peterbaumert/obd-v2x-dongle/docs/img/pcb-bottom.png

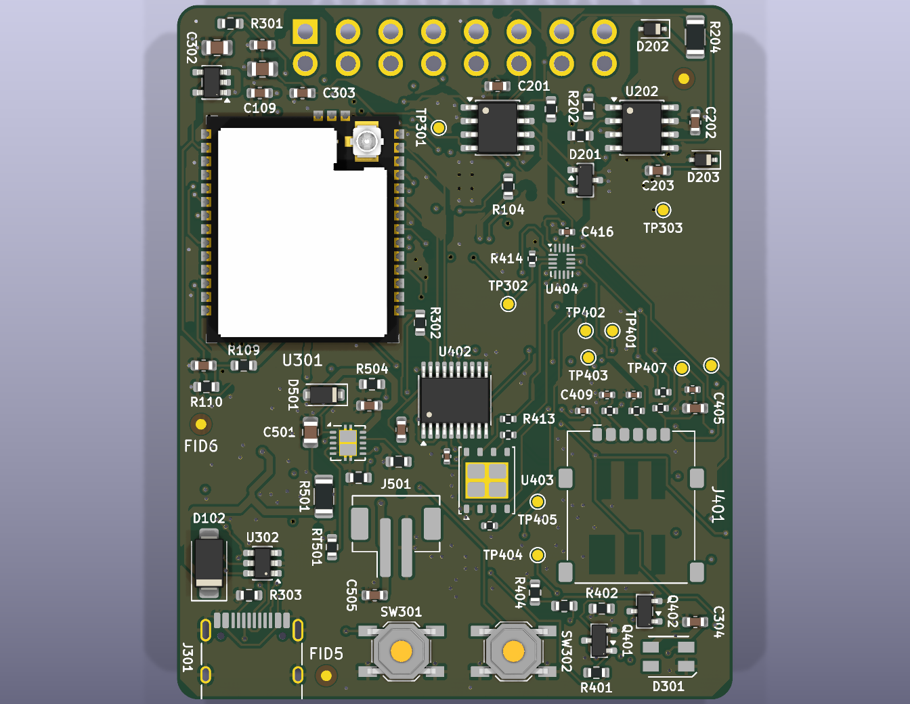
docs/img/pcb-bottom.png
