peterbaumert/obd-v2x-dongle/docs/img/pcb-top.png

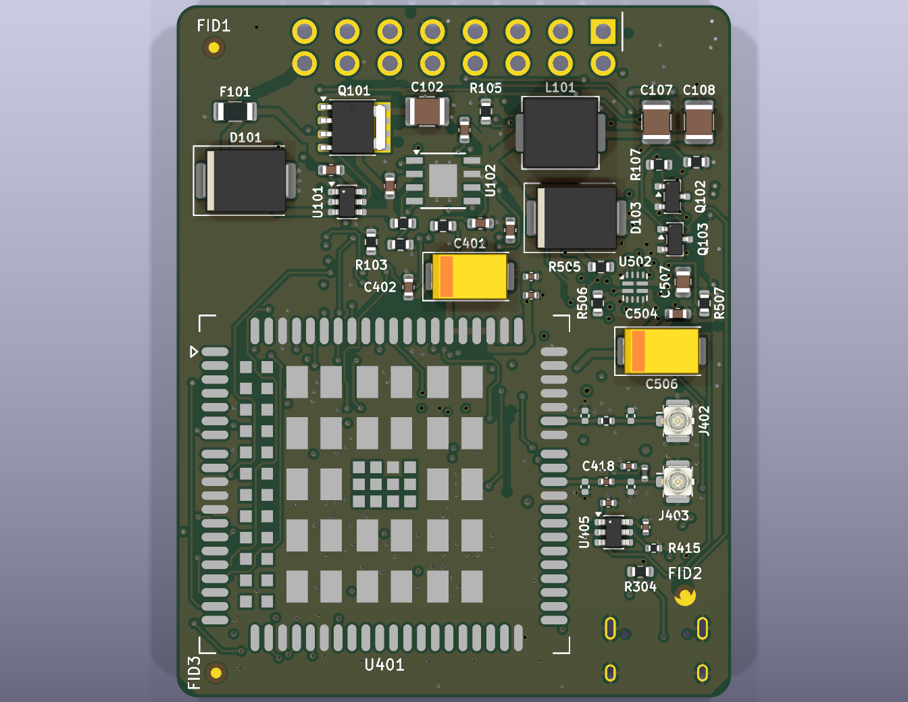
docs/img/pcb-top.png
