peterbaumert/obd-v2x-dongle/mechanical/out/case_bottom_shell.png

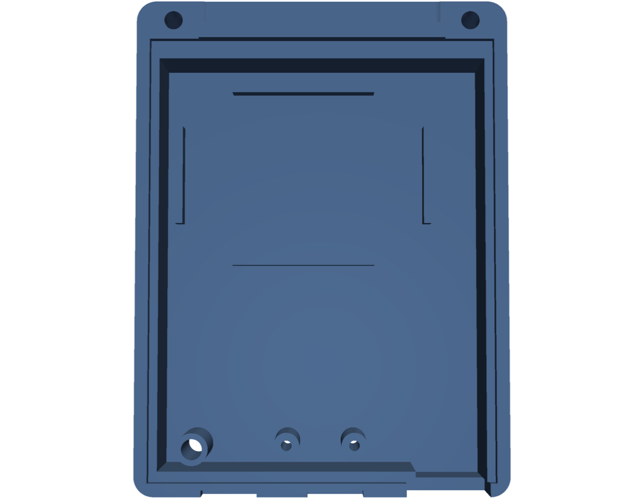
mechanical/out/case_bottom_shell.png
