peterbaumert/obd-v2x-dongle/mechanical/out/case_closed_rear.png

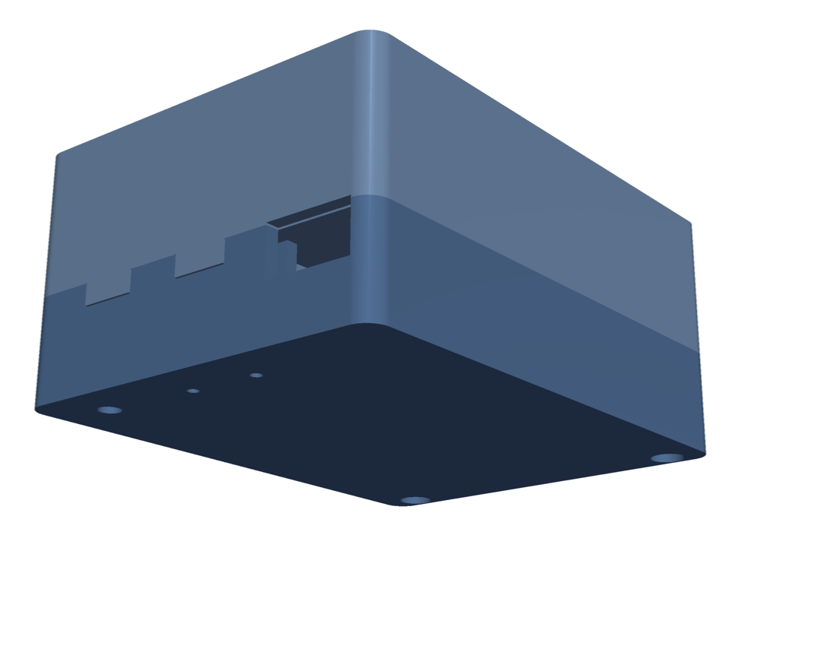
mechanical/out/case_closed_rear.png
