peterbaumert/obd-v2x-dongle/mechanical/out/case_lid_inside.png

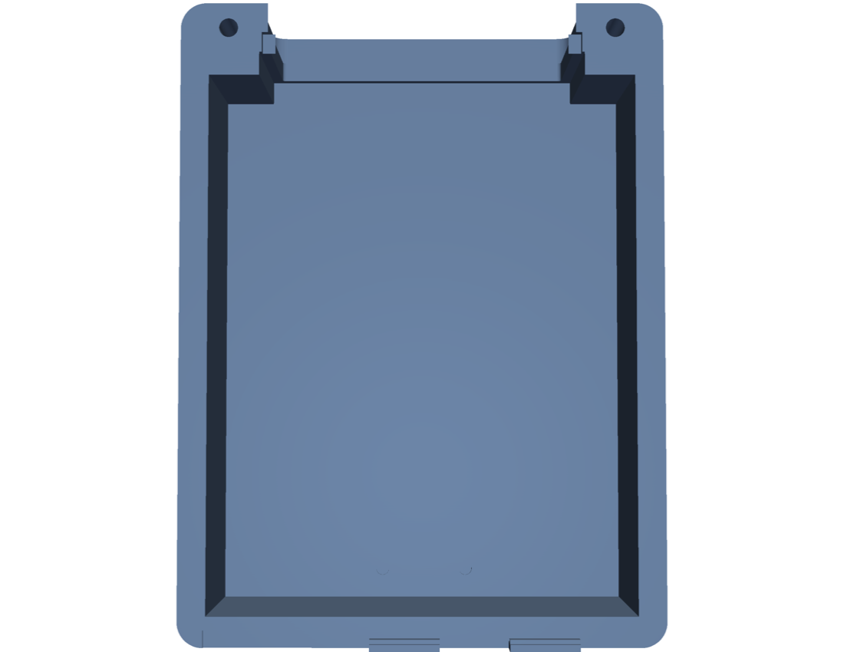
mechanical/out/case_lid_inside.png
