peterbaumert/obd-v2x-dongle/docs/bom.csv

Reference | Value | Footprint | MPN | Manufacturer | LCSC | Qty | DNP
C101,C104,C111,C201,C303,C304,C402,C405,C406 | 100nF | Capacitor_SMD:C_0603_1608Metric |  |  |  | 9
C102 | 10uF 50V | Capacitor_SMD:C_1210_3225Metric |  |  |  | 1
C103,C202 | 100nF 50V | Capacitor_SMD:C_0603_1608Metric |  |  |  | 2
C105 | 5.6nF | Capacitor_SMD:C_0603_1608Metric |  |  |  | 1
C106 | 47pF | Capacitor_SMD:C_0603_1608Metric |  |  |  | 1
C107,C108 | 47uF 10V | Capacitor_SMD:C_1210_3225Metric |  |  |  | 2
C109,C301,C502,C505 | 1uF | Capacitor_SMD:C_0603_1608Metric |  |  |  | 4
C110,C302,C507 | 10uF | Capacitor_SMD:C_0805_2012Metric |  |  |  | 3
C203 | 220pF 50V | Capacitor_SMD:C_0603_1608Metric |  |  |  | 1
C401 | 220uF 6.3V | Capacitor_Tantalum_SMD:CP_EIA-7343-31_Kemet-D | T495D227K006ATE100 | Kemet | C2798131 | 1
C403,C407,C408,C409 | 33pF | Capacitor_SMD:C_0402_1005Metric |  |  |  | 4
C404 | 10pF | Capacitor_SMD:C_0402_1005Metric |  |  |  | 1
C410,C415,C416,C419,C420 | 100nF | Capacitor_SMD:C_0402_1005Metric |  |  |  | 5
C411,C412,C413,C414 | DNP | Capacitor_SMD:C_0402_1005Metric |  |  |  | 4 | DNP
C417,C418 | 33pF | Capacitor_SMD:C_0402_1005Metric | 0402CG330J500NT | FH | C1562 | 2
C501 | 1uF 50V | Capacitor_SMD:C_0805_2012Metric |  |  |  | 1
C504 | 10nF | Capacitor_SMD:C_0603_1608Metric |  |  |  | 1
C506 | 220uF | Capacitor_Tantalum_SMD:CP_EIA-7343-31_Kemet-D | T495D227K006ATE100 | KEMET | C2798131 | 1
D101 | SMCJ33CA | Diode_SMD:D_SMC | SMCJ33CA | Littelfuse | C310048 | 1
D102 | SS14 | Diode_SMD:D_SMA | SS14 | MDD | C2480 | 1
D103 | B560C | Diode_SMD:D_SMC | B560C-13-F | Diodes Inc | C85100 | 1
D201 | NUP2105L | Package_TO_SOT_SMD:SOT-23 | SZNUP2105LT1G | onsemi | C233494 | 1
D202 | B0540WS | Diode_SMD:D_SOD-323 | B0540WS-7 | Diodes Inc | C52754523 | 1
D203 | PESD1LIN | Diode_SMD:D_SOD-323 | PESD1LIN,115 | Nexperia | C58901 | 1
D301 | SK6812MINI-HS | obd-v2x:LED_SK6812MINI-HS_3.7x3.5mm | SK6812MINI-HS | OPSCO | C2922787 | 1
D501 | SMF24A | Diode_SMD:D_SOD-123F | SMF24A | Littelfuse | C315999 | 1
F101 | 2A slow | Fuse:Fuse_1206_3216Metric | 0466002.NRHF | Littelfuse | C3105 | 1
J201 | OBD2_J1962_Plug | obd-v2x:OBD2_J1962_Plug_PCB | CR-PG001 (OBD2 male 90deg PCB, hand-fitted) | Jiatel or equivalent |  | 1
J301 | USB-C | Connector_USB:USB_C_Receptacle_HRO_TYPE-C-31-M-12 | TYPE-C-31-M-12 | HRO | C165948 | 1
J401 | Nano-SIM | Connector_Card:nanoSIM_GCT_SIM8060-6-0-14-00 | SIM8060-6-0-14-00-A | GCT | C6296715 | 1
J402 | U.FL LTE main | Connector_Coaxial:U.FL_Hirose_U.FL-R-SMT-1_Vertical | U.FL-R-SMT-1(10) | Hirose | C88373 | 1
J403 | U.FL GNSS | Connector_Coaxial:U.FL_Hirose_U.FL-R-SMT-1_Vertical | U.FL-R-SMT-1(10) | Hirose | C88373 | 1
J501 | Battery 1S | Connector_JST:JST_PH_B2B-PH-SM4-TB_1x02-1MP_P2.00mm_Vertical | B2B-PH-SM4-TB(LF)(SN) | JST | C160352 | 1
L101 | 6.8uH 4.5A | Inductor_SMD:L_Sunlord_MWSA0605S | MWSA0605S-6R8MT | Sunlord | C408466 | 1
L401 | 27nH | Inductor_SMD:L_0402_1005Metric | LQG15HS27NJ02D | Murata | C12669 | 1
Q101 | PSMN7R0-60YS | Package_TO_SOT_SMD:LFPAK56 | PSMN7R0-60YS,115 | Nexperia | C478143 | 1
Q102 | AO3401A | Package_TO_SOT_SMD:SOT-23 | AO3401A | AOS | C15127 | 1
Q103 | 2N7002 | Package_TO_SOT_SMD:SOT-23 | 2N7002 | onsemi | C8545 | 1
Q401,Q402 | MMBT3904 | Package_TO_SOT_SMD:SOT-23 | MMBT3904 | onsemi | C20526 | 2
R101 | 470k | Resistor_SMD:R_0603_1608Metric |  |  |  | 1
R102 | 120k | Resistor_SMD:R_0603_1608Metric |  |  |  | 1
R103 | 162k | Resistor_SMD:R_0603_1608Metric |  |  |  | 1
R104 | 37.4k | Resistor_SMD:R_0603_1608Metric |  |  |  | 1
R105,R110,R201,R301,R302 | 10k | Resistor_SMD:R_0603_1608Metric |  |  |  | 5
R106 | 12k | Resistor_SMD:R_0603_1608Metric |  |  |  | 1
R107,R108,R109,R203 | 100k | Resistor_SMD:R_0603_1608Metric |  |  |  | 4
R202,R401,R403 | 4.7k | Resistor_SMD:R_0603_1608Metric |  |  |  | 3
R204 | 510 0.5W | Resistor_SMD:R_1206_3216Metric |  |  |  | 1
R303,R304 | 5.1k | Resistor_SMD:R_0603_1608Metric |  |  |  | 2
R402,R404 | 47k | Resistor_SMD:R_0603_1608Metric |  |  |  | 2
R405,R406,R407,R411,R412,R413 | 22R | Resistor_SMD:R_0402_1005Metric |  |  |  | 6
R408 | 15k | Resistor_SMD:R_0402_1005Metric |  |  |  | 1
R409 | 0R | Resistor_SMD:R_0402_1005Metric |  |  |  | 1
R414 | 100k | Resistor_SMD:R_0402_1005Metric |  |  |  | 1
R415 | 232k | Resistor_SMD:R_0402_1005Metric |  |  |  | 1
R501 | 33R 0.5W | Resistor_SMD:R_1206_3216Metric |  |  |  | 1
R502 | 4.3k | Resistor_SMD:R_0603_1608Metric |  |  |  | 1
R503 | 24k 1% | Resistor_SMD:R_0603_1608Metric |  |  |  | 1
R504,R505 | 82k 1% | Resistor_SMD:R_0603_1608Metric |  |  |  | 2
R506 | 10k 1% | Resistor_SMD:R_0603_1608Metric |  |  |  | 1
R507 | 30.1k 1% | Resistor_SMD:R_0603_1608Metric |  |  |  | 1
RT501 | 10k NTC | Resistor_SMD:R_0603_1608Metric | SDNT1608X103F3435FTF | Sunlord | C525660 | 1
SW301 | RESET | Button_Switch_SMD:SW_SPST_TL3342 | TL3342F450QG | E-Switch | C2886897 | 1
SW302 | BOOT | Button_Switch_SMD:SW_SPST_TL3342 | TL3342F450QG | E-Switch | C2886897 | 1
TP301 | UART0_TX | TestPoint:TestPoint_Pad_D1.0mm |  |  |  | 1
TP302 | SIM_SEL | TestPoint:TestPoint_Pad_D1.0mm |  |  |  | 1
TP303 | GND | TestPoint:TestPoint_Pad_D1.0mm |  |  |  | 1
TP401 | LTE_USB_VBUS | TestPoint:TestPoint_Pad_D1.0mm |  |  |  | 1
TP402 | LTE_USB_DP | TestPoint:TestPoint_Pad_D1.0mm |  |  |  | 1
TP403 | LTE_USB_DM | TestPoint:TestPoint_Pad_D1.0mm |  |  |  | 1
TP404 | LTE_USB_BOOT | TestPoint:TestPoint_Pad_D1.0mm |  |  |  | 1
TP405 | LTE_DBG_TXD | TestPoint:TestPoint_Pad_D1.0mm |  |  |  | 1
TP406 | LTE_DBG_RXD | TestPoint:TestPoint_Pad_D1.0mm |  |  |  | 1
TP407 | LTE_1V8 | TestPoint:TestPoint_Pad_D1.0mm |  |  |  | 1
U101 | LM74700-Q1 | Package_TO_SOT_SMD:SOT-23-6 | LM74700QDBVRQ1 | TI | C2941042 | 1
U102 | TPS54360DDA | Package_SO:TI_SO-PowerPAD-8_ThermalVias | TPS54360DDAR | TI | C44377 | 1
U103 | TLV75733PDBV | Package_TO_SOT_SMD:SOT-23-5 | TLV75733PDBVR | TI | C485517 | 1
U201 | TCAN334 | Package_SO:SOIC-8_3.9x4.9mm_P1.27mm | TCAN334DR | TI | C2871143 | 1
U202 | TJA1021T/20 | Package_SO:SOIC-8_3.9x4.9mm_P1.27mm | TJA1021T/20/CM,118 | NXP | C128810 | 1
U301 | ESP32-C5-WROOM-1U-N16R8 | obd-v2x:ESP32-C5-WROOM-1U | ESP32-C5-WROOM-1U-N16R8-V1.2 | Espressif | C54951857 | 1
U302 | USBLC6-2SC6 | Package_TO_SOT_SMD:SOT-23-6 | USBLC6-2SC6 | ST | C2827654 | 1
U401 | EC200U-EU | obd-v2x:Quectel_EC200U | EC200UEUAA-N05-SGNSA | Quectel | C2942341 | 1
U402 | TXS0108EPW | Package_SO:TSSOP-20_4.4x6.5mm_P0.65mm | TXS0108EPWR | TI | C17206 | 1
U403 | eSIM MFF2 | Package_SON:WSON-8-1EP_6x5mm_P1.27mm_EP3.4x4mm | MFF2 eSIM, optional (DNP) |  |  | 1 | DNP
U404 | FSA2567UMX | Package_DFN_QFN:UQFN-16_1.8x2.6mm_P0.4mm | FSA2567UMX | onsemi | C357761 | 1
U405 | TPS2552DBVR-1 | Package_TO_SOT_SMD:SOT-23-6 | TPS2552DBVR-1 | TI | C140331 | 1
U501 | BQ25171-Q1 | Package_SON:Texas_DRC0010J | BQ25171QWDRCRQ1 | Texas Instruments | C2861221 | 1
U502 | TPS2121 | Package_DFN_QFN:Texas_VQFN-HR-12_2x2.5mm_P0.5mm | TPS2121RUXR | Texas Instruments | C485916 | 1
