peterbaumert/obd-v2x-dongle/mechanical/out/case_bottom.step

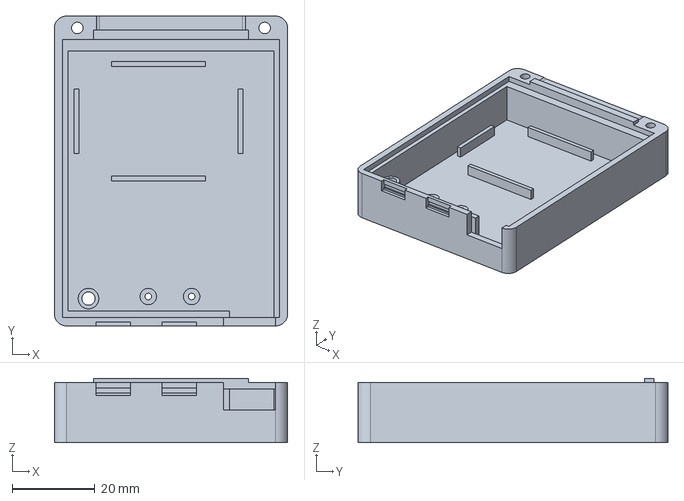
[picture p9: CAD file, 2026-11-13]
mechanical/out/case_bottom.step
56.6 x 75.2 x 15.6 mm
