peterbaumert/obd-v2x-dongle/mechanical/out/case_lid.step

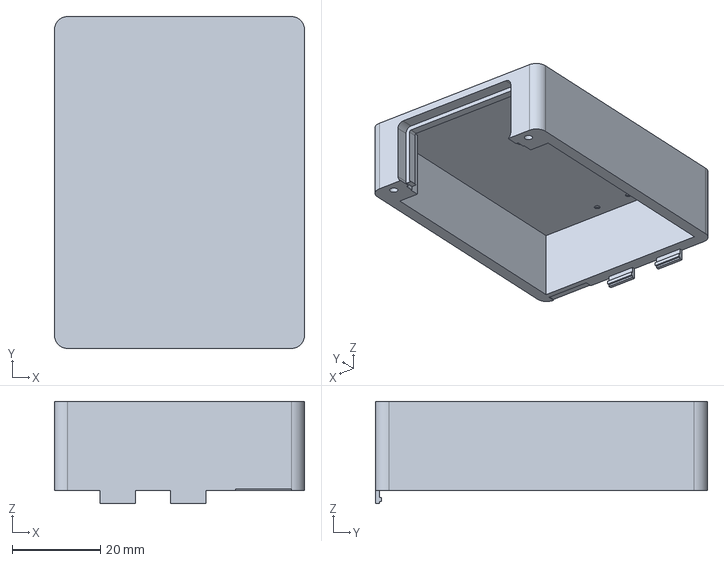
[picture p10: CAD file, 2026-11-13]
mechanical/out/case_lid.step
56.6 x 75.2 x 23.1 mm
