peterbaumert/obd-v2x-dongle/(list of files, cad)

Other CAD files:
mechanical/out/case_bottom.stl
mechanical/out/case_lid.stl
