peterbaumert/obd-v2x-dongle/docs/schematic.pdf

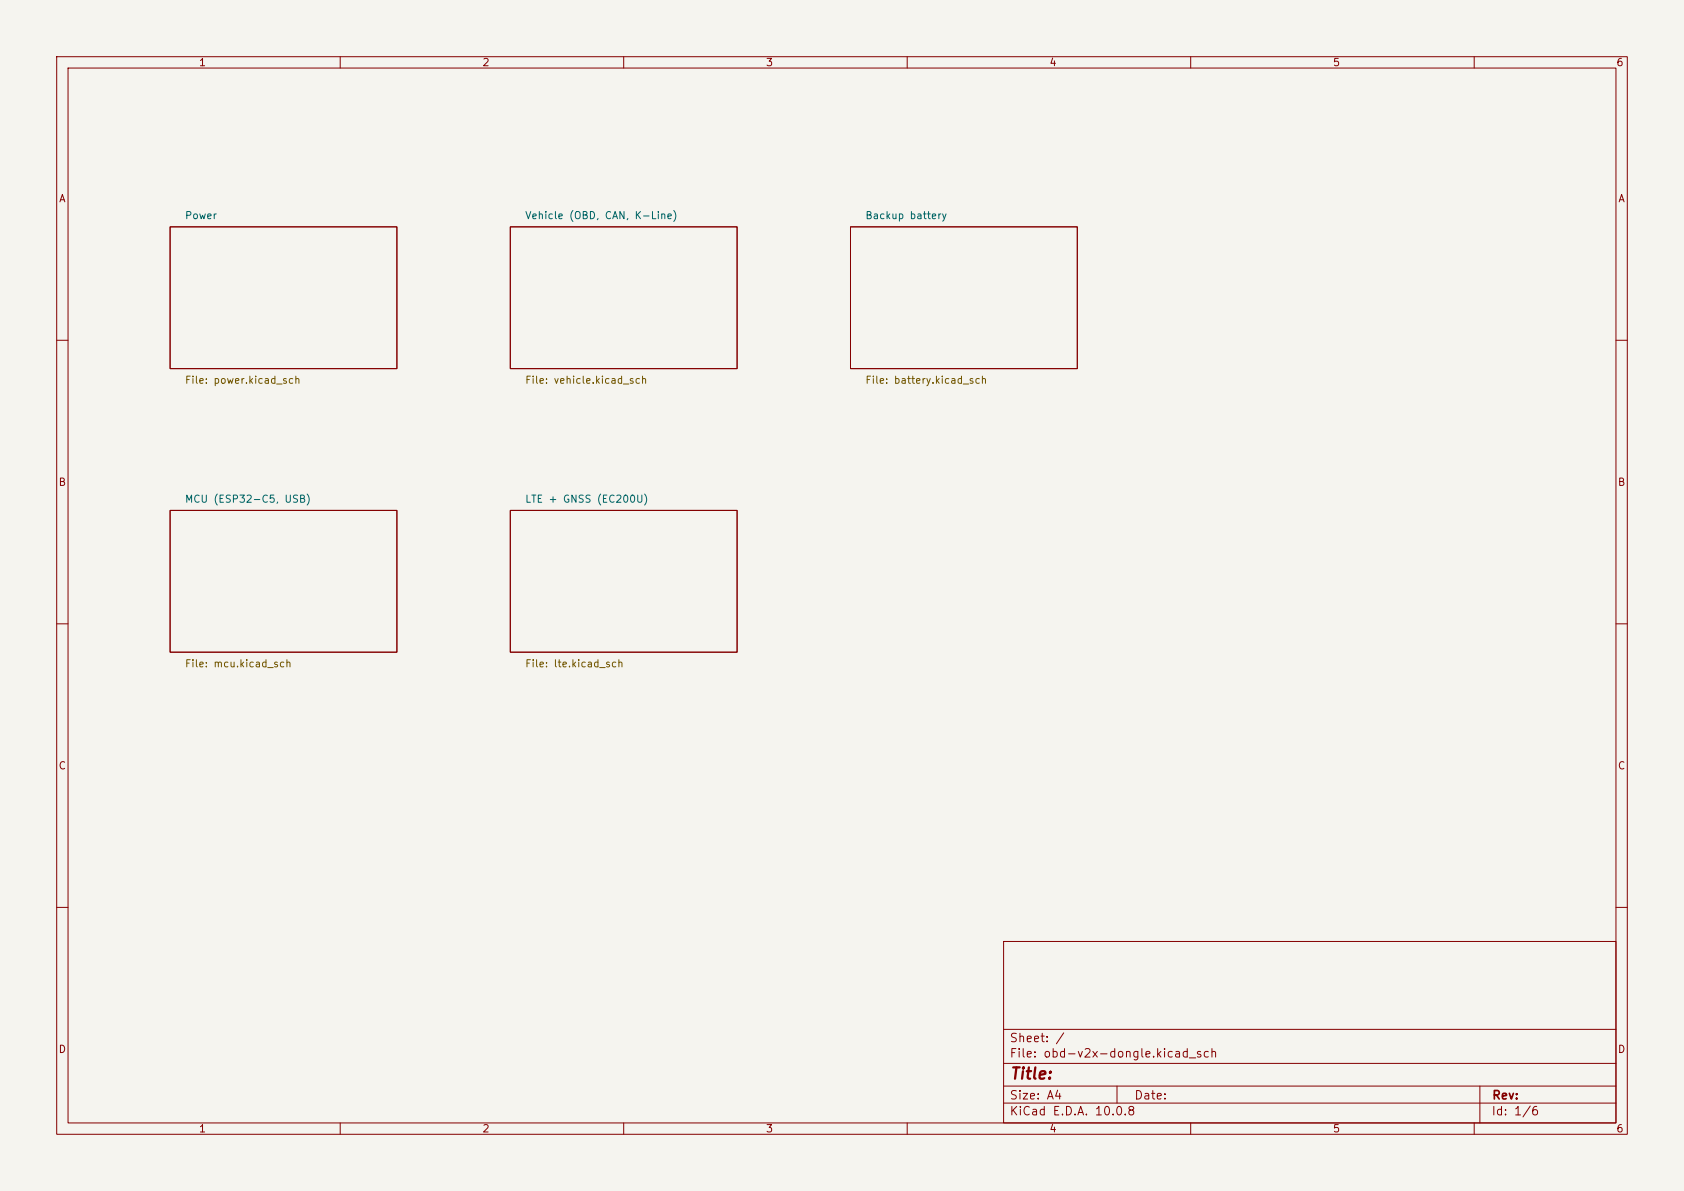
[picture p11: page 1]

LTE + GNSS (EC200U) File: lte.kicad_sch MCU (ESP32-C5, USB) File: mcu.kicad_sch Power File: power.kicad_sch

Size: A4 | Rev:
KiCad E.D.A. 10.0.8 | Id: 1/6

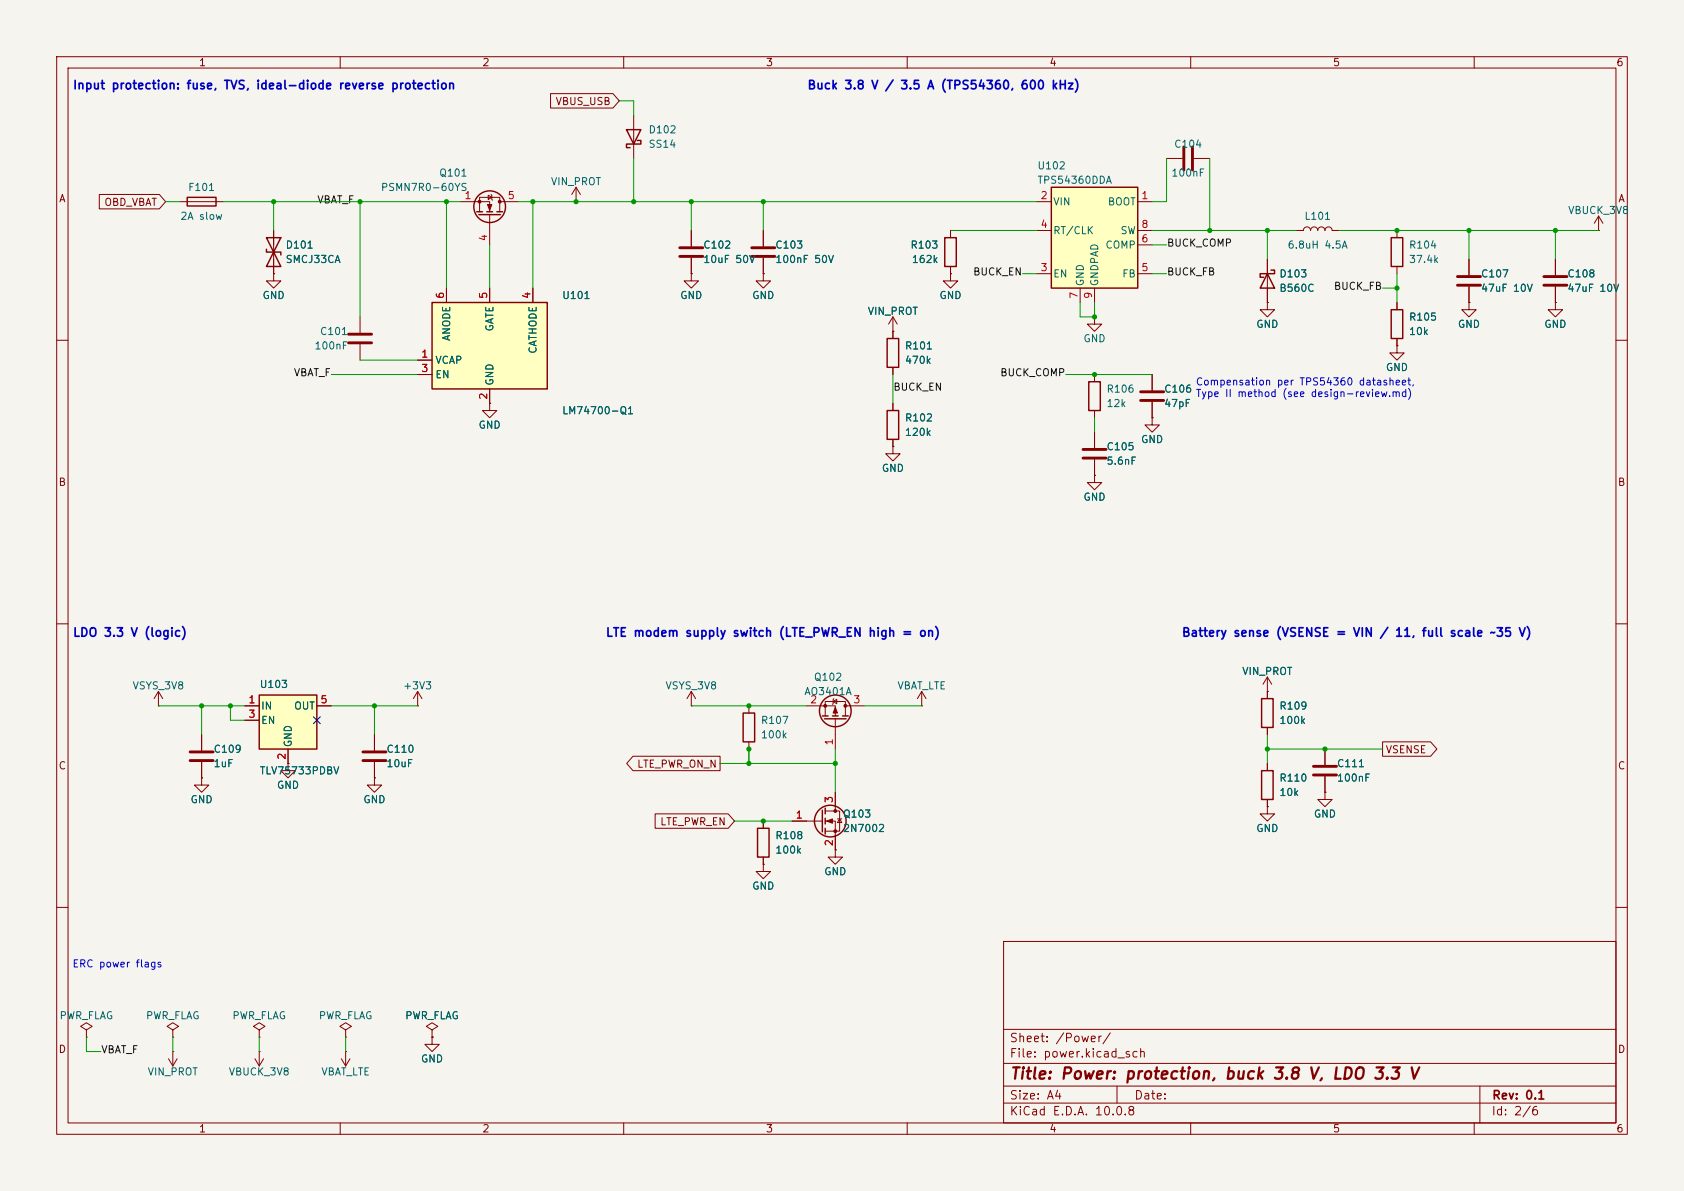
[picture p12: page 2]

Battery sense (VSENSE = VIN / 11, full scale ~35 V) R101

Compensation per TPS54360 datasheet,
Type II method (see design-review.md)

LTE modem supply switch (LTE_PWR_EN high = on)

Sheet: /Power/
File: power.kicad_sch
Title: Power: protection, buck 3.8 V, LDO 3.3 V

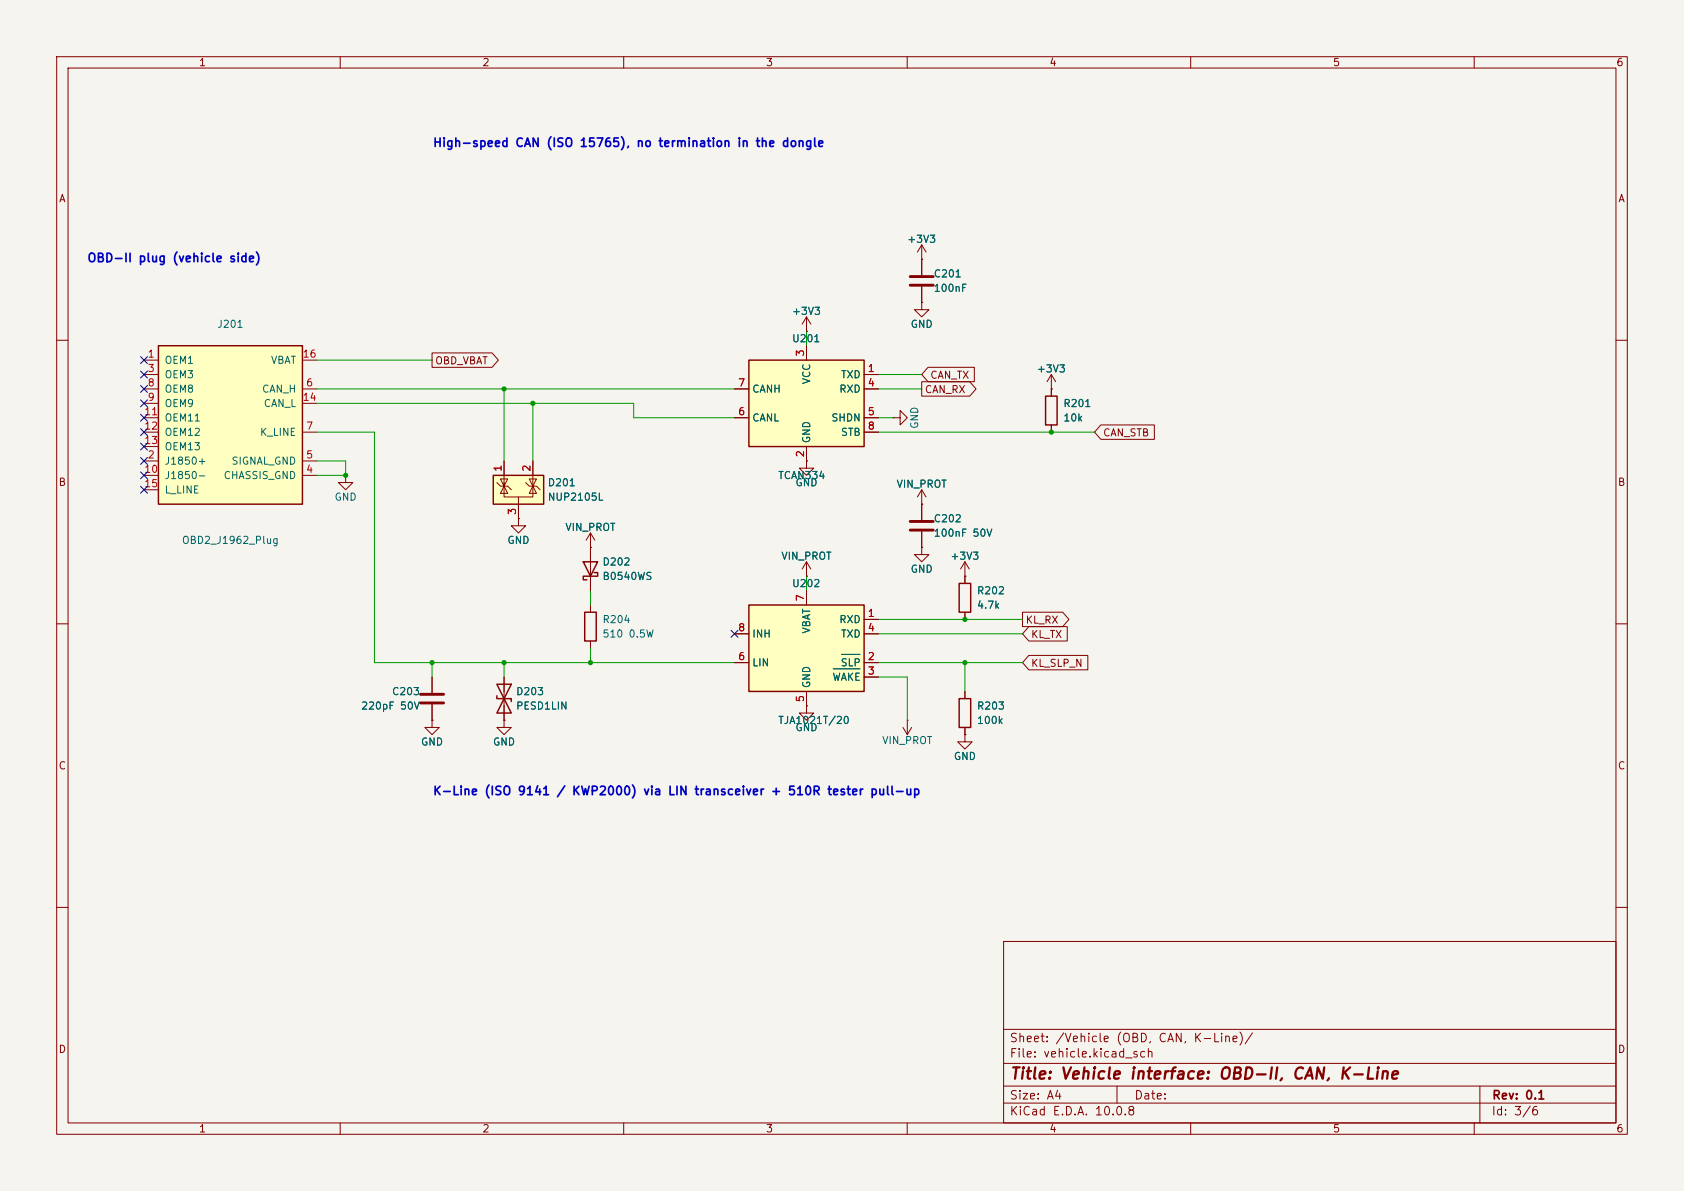
[picture p13: page 3]

High-speed CAN (ISO 15765), no termination in the dongle

K-Line (ISO 9141 / KWP2000) via LIN transceiver + 510R tester pull-up

Sheet: /Vehicle (OBD, CAN, K-Line)/
File: vehicle.kicad_sch
Title: Vehicle interface: OBD-II, CAN, K-Line

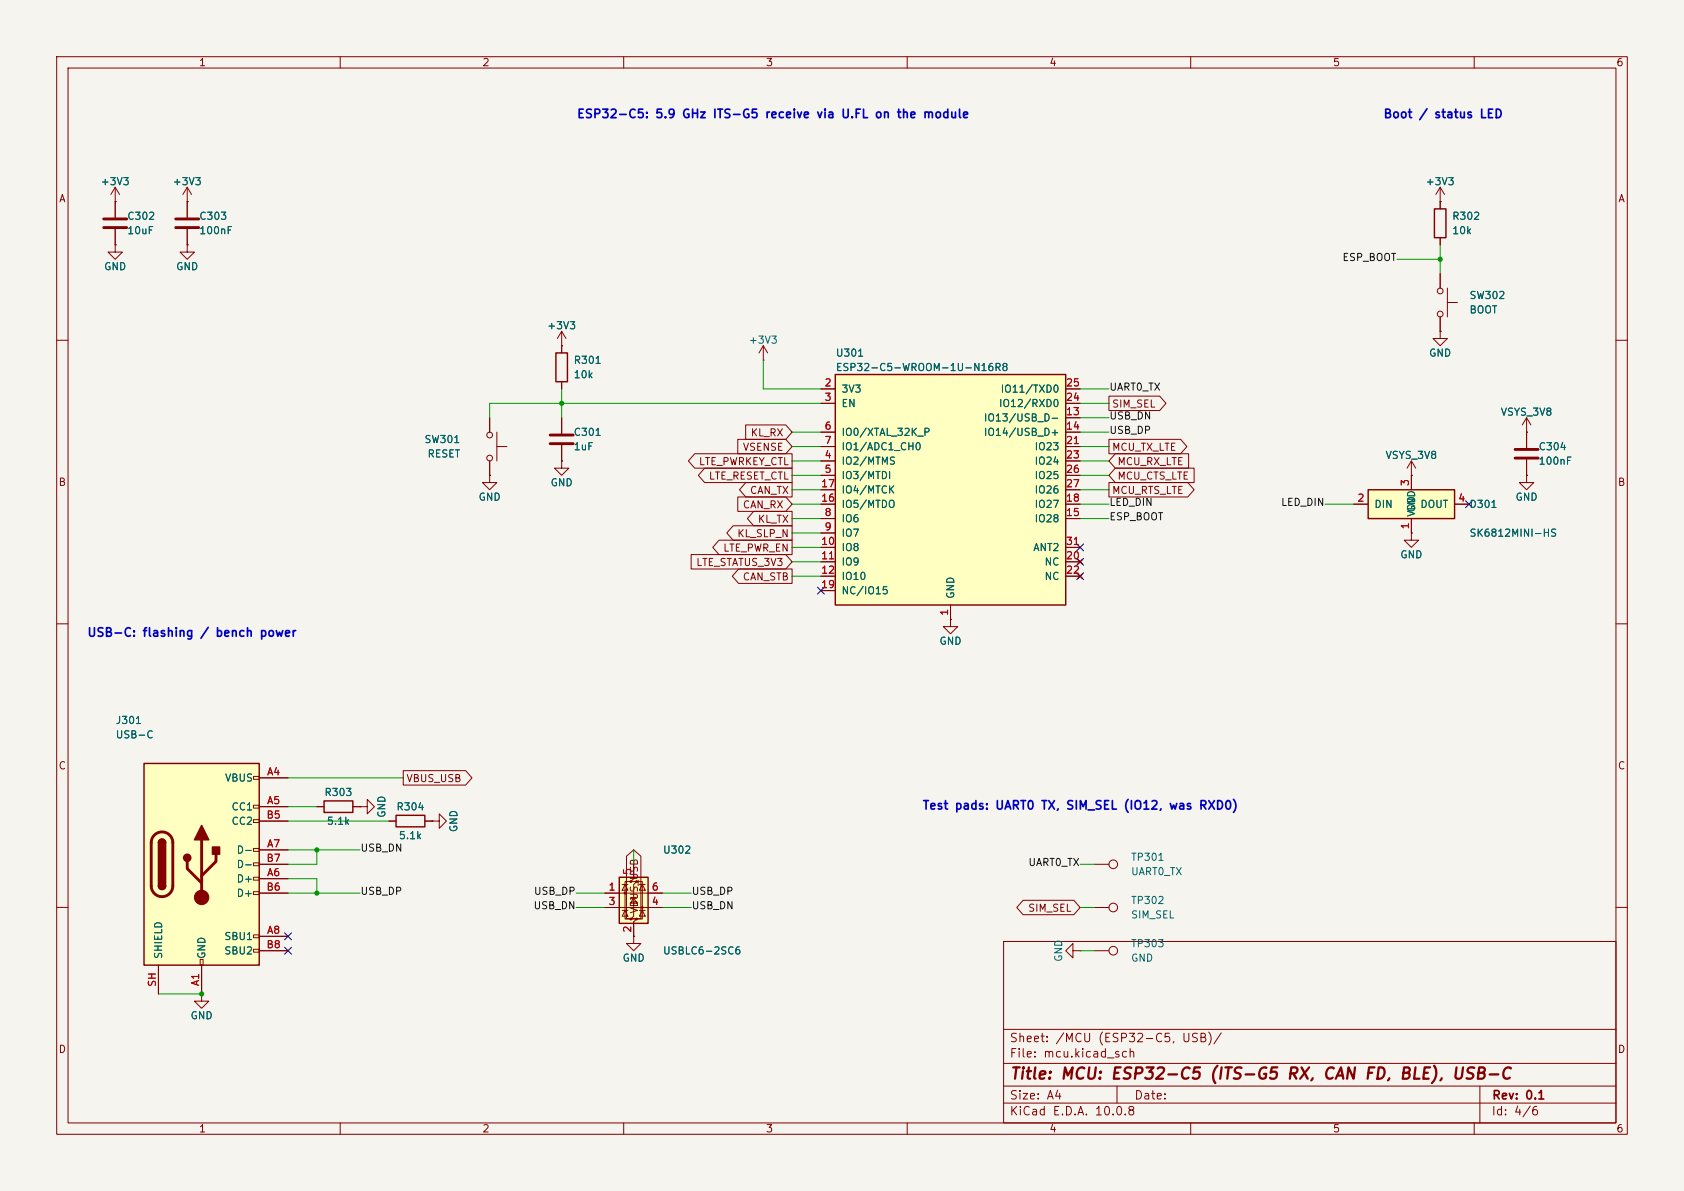
[picture p14: page 4]

Test pads: UART0 TX, SIM_SEL (IO12, was RXD0)

Sheet: /MCU (ESP32-C5, USB)/
File: mcu.kicad_sch
Title: MCU: ESP32-C5 (ITS-G5 RX, CAN FD, BLE), USB-C

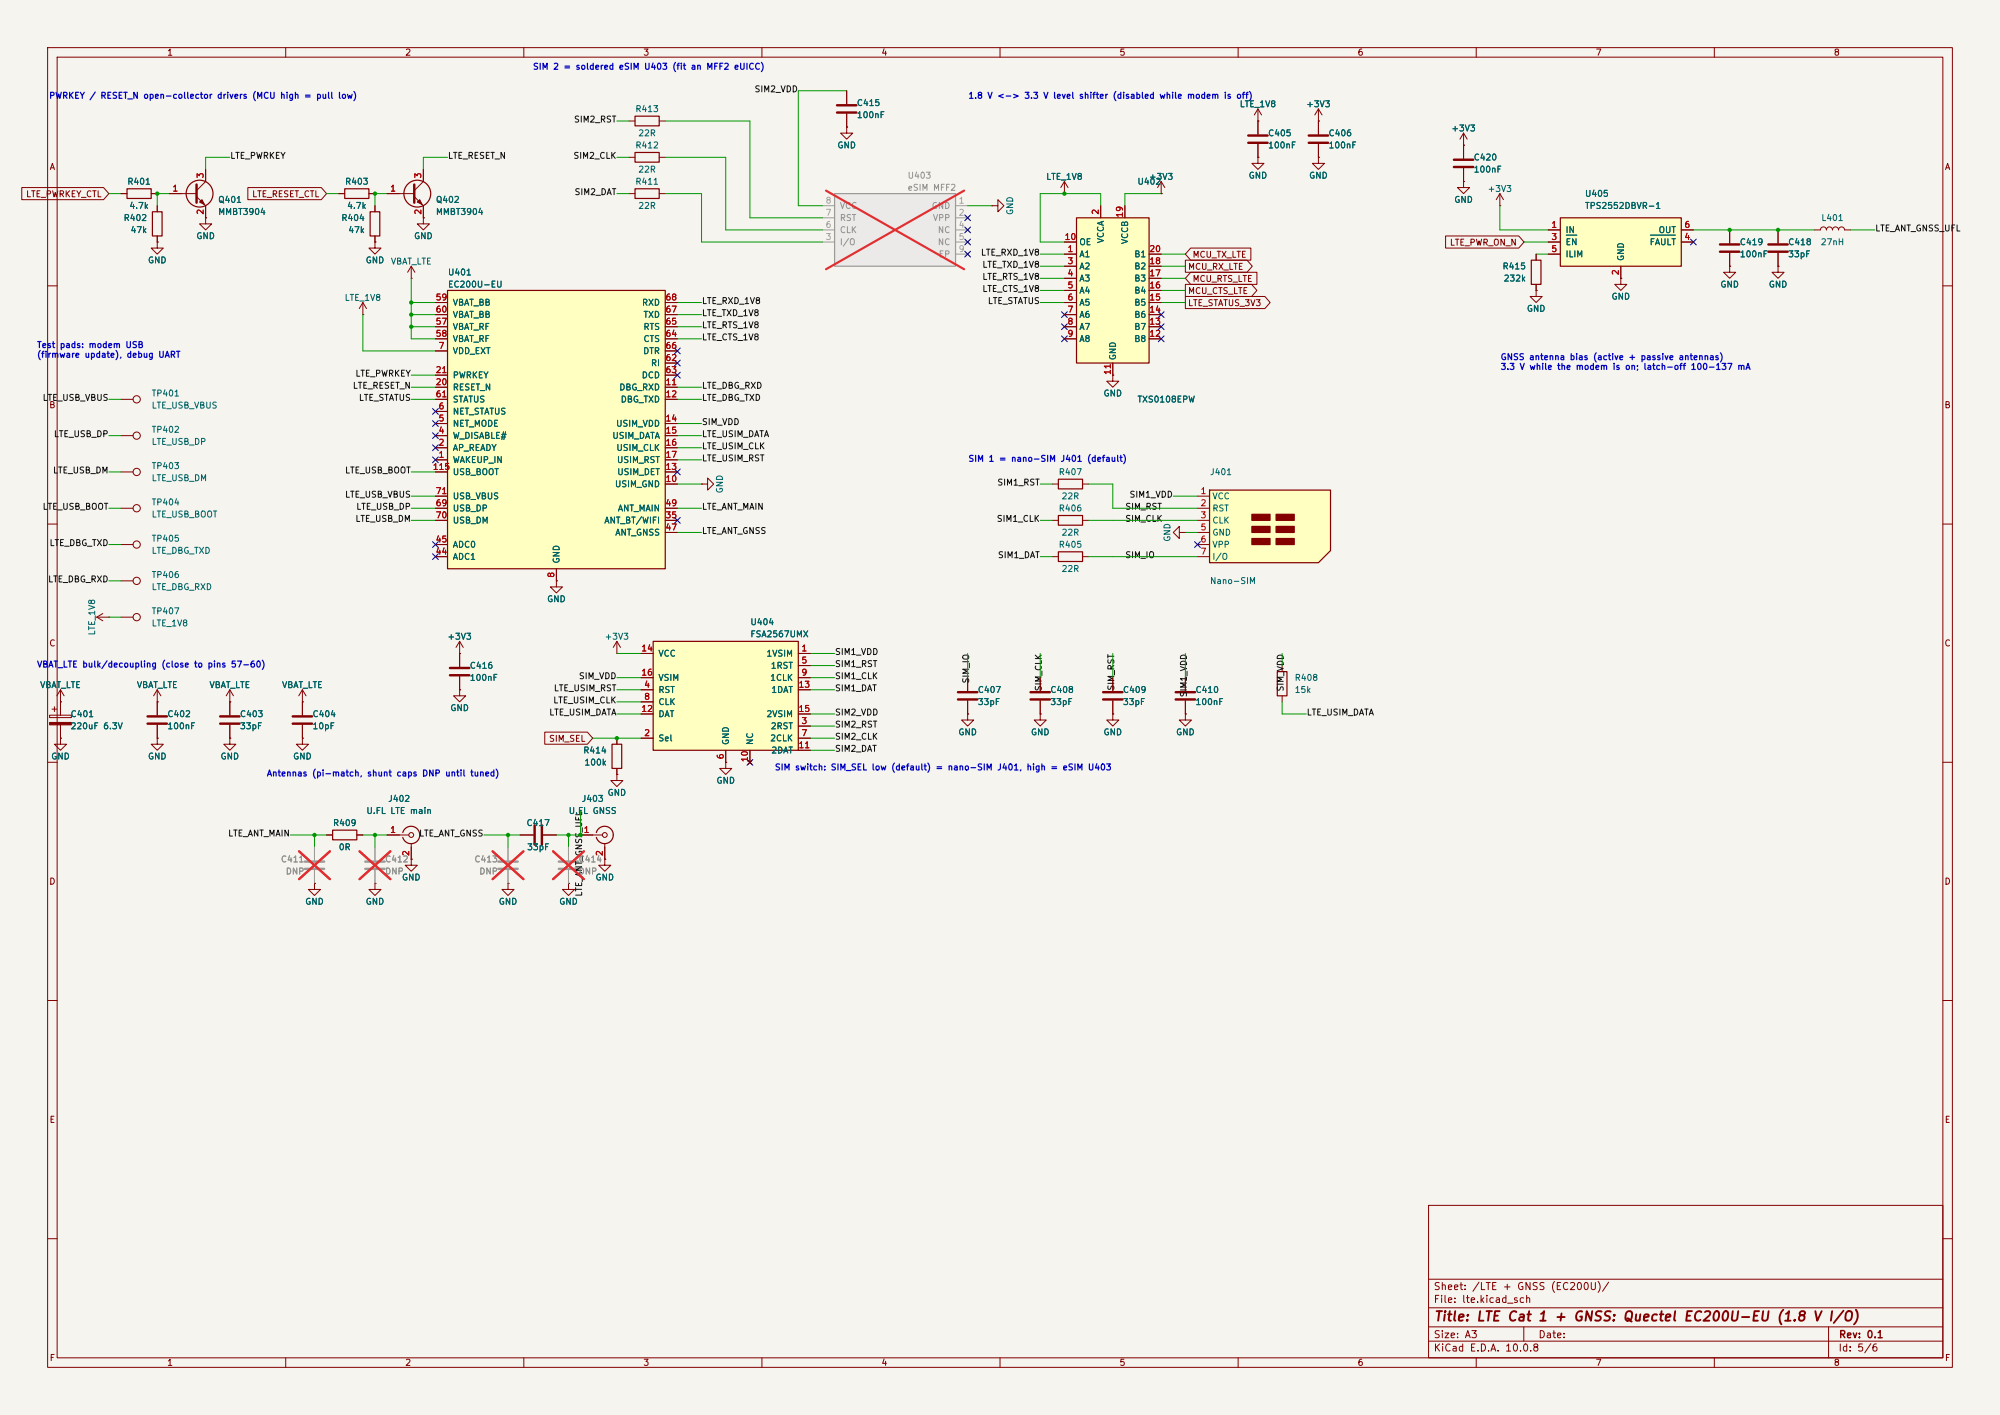
[picture p15: page 5]

VBAT_LTE bulk/decoupling (close to pins 57-60) Test pads: modem USB

VCC 1 RST 2 CLK 3 GND 5

Antennas (pi-match, shunt caps DNP until tuned)

J402 U.FL LTE main C411 DNP

Sheet: /LTE + GNSS (EC200U)/
File: lte.kicad_sch
Title: LTE Cat 1 + GNSS: Quectel EC200U-EU (1.8 V I/O)

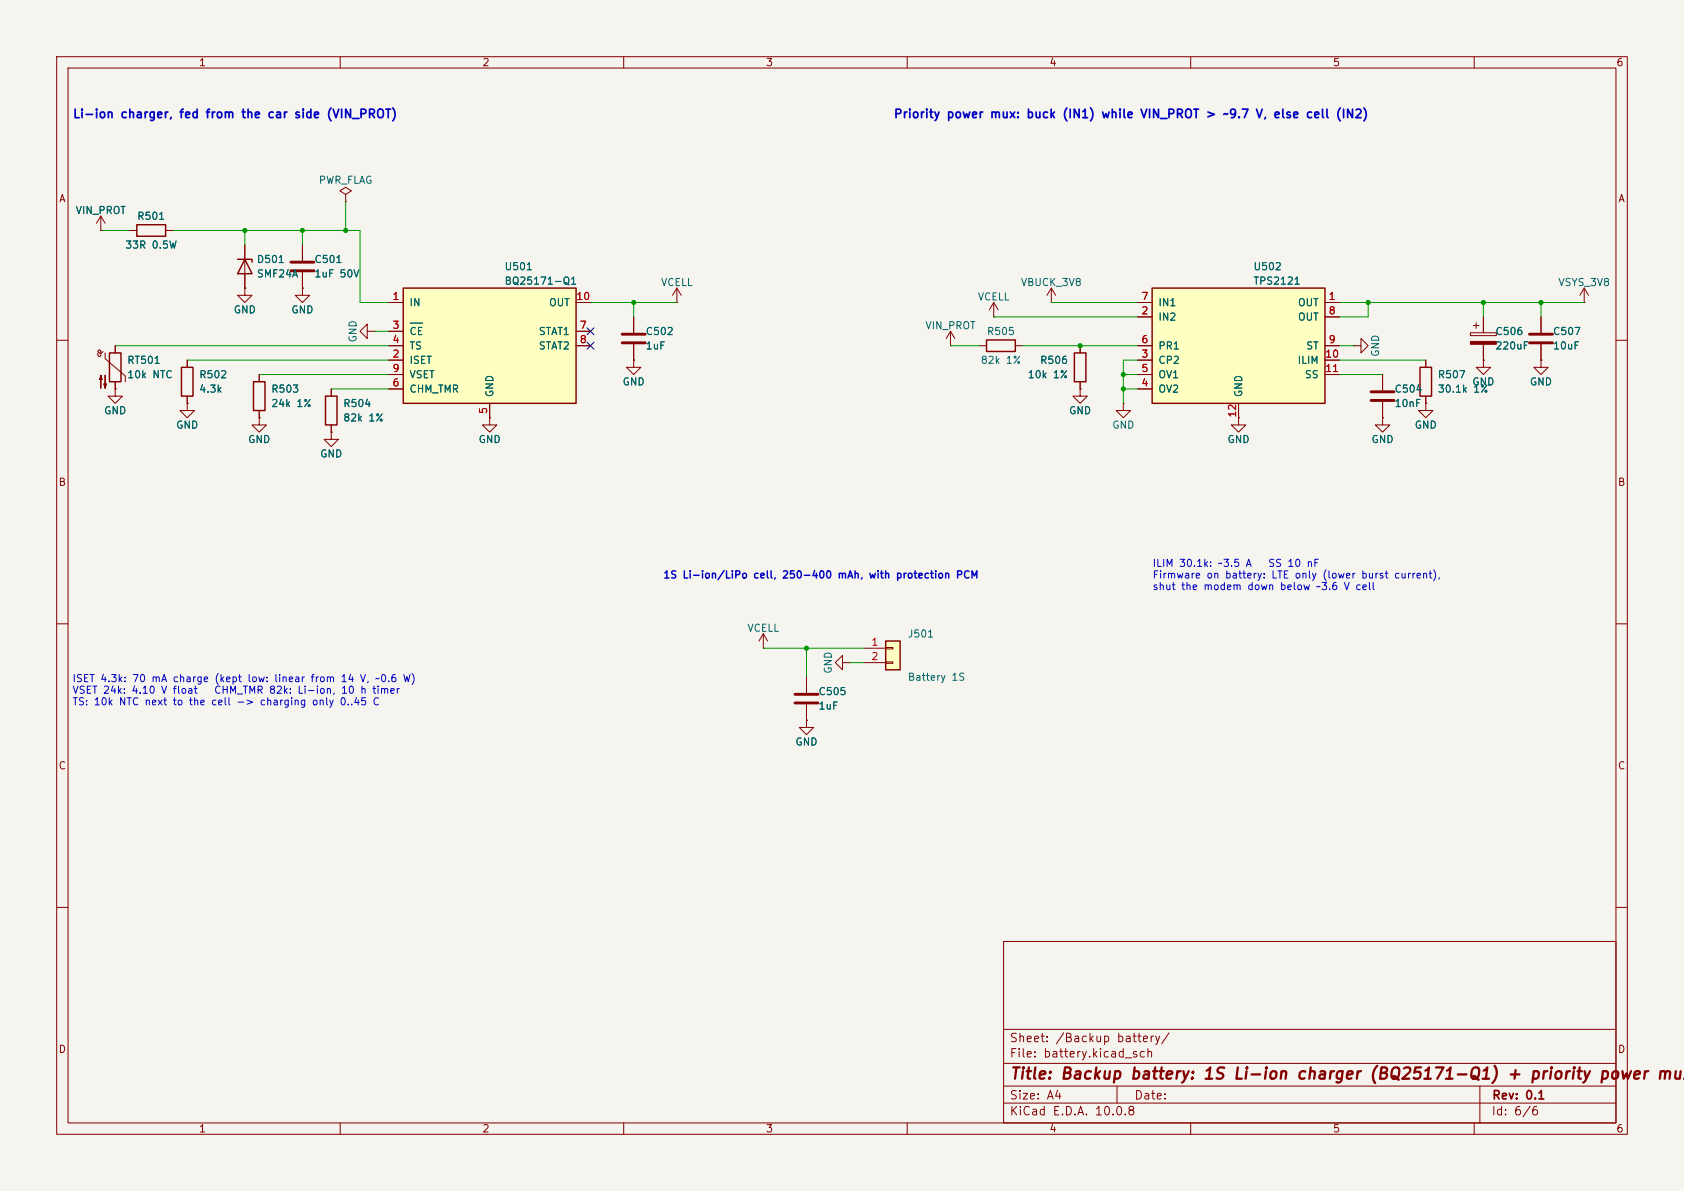
[picture p16: page 6]

Li-ion charger, fed from the car side (VIN_PROT)

Firmware on battery: LTE only (lower burst current), shut the modem down below ~3.6 V cell Priority power mux: buck (IN1) while VIN_PROT > ~9.7 V, else cell (IN2) 1S Li-ion/LiPo cell, 250-400 mAh, with protection PCM

Sheet: /Backup battery/
File: battery.kicad_sch
Title: Backup battery: 1S Li-ion charger (BQ25171-Q1) + priority power mux (TPS2121)
