peterbaumert/obd-v2x-dongle/hardware/obd-v2x-dongle.kicad_pcb

## KiCad design hardware/obd-v2x-dongle.kicad_pcb (2026-11-13)

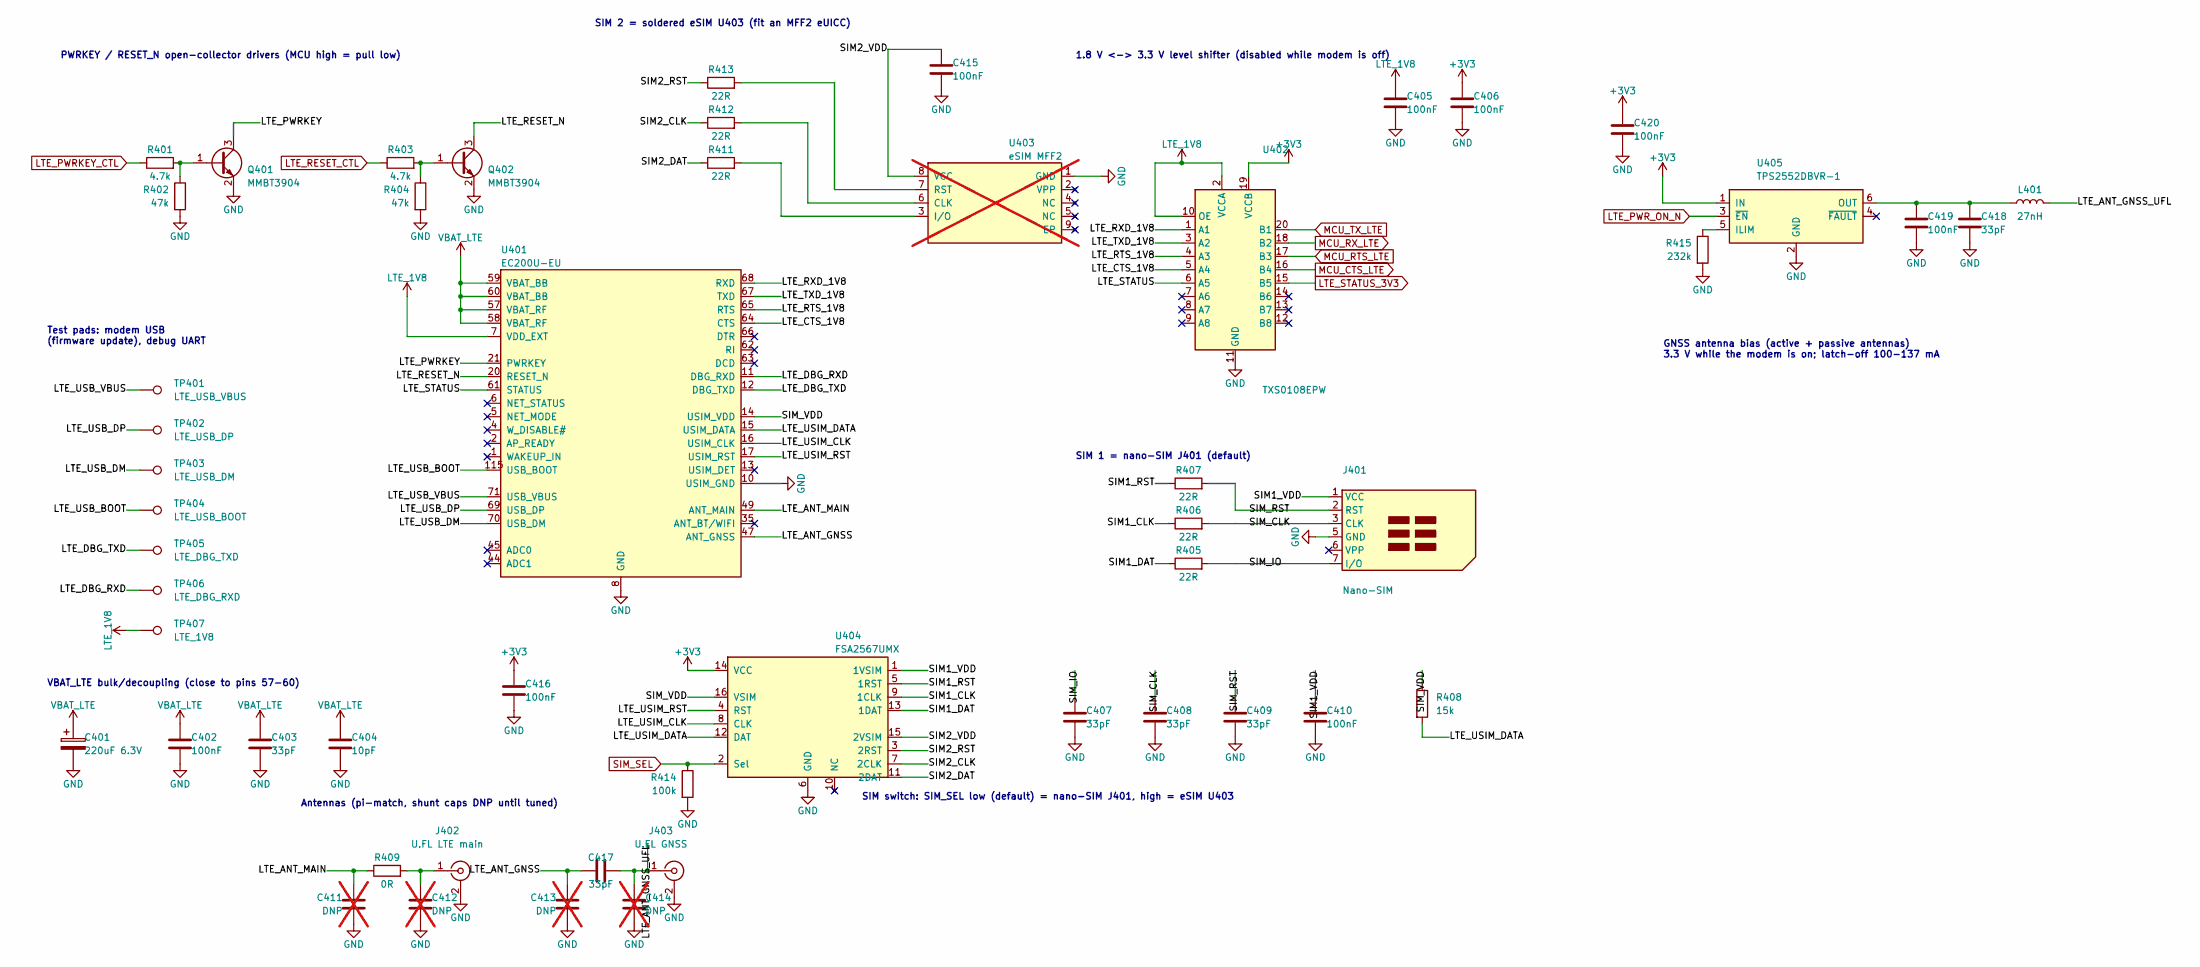
[picture p17: schematic lte.kicad_sch, LTE Cat 1 + GNSS: Quectel EC200U-EU (1.8 V I/O)]

Parts:
C401: 220uF 6.3V; CP_EIA-7343-31_Kemet-D; MPN T495D227K006ATE100; LCSC C2798131
C402, C405, C406: 100nF; C_0603_1608Metric
C403, C407, C408, C409: 33pF; C_0402_1005Metric
C404: 10pF; C_0402_1005Metric
C410, C415, C416, C419, C420: 100nF; C_0402_1005Metric
C411, C412, C413, C414: DNP; C_0402_1005Metric; not fitted
C417, C418: 33pF; C_0402_1005Metric; MPN 0402CG330J500NT; LCSC C1562
J401: Nano-SIM; nanoSIM_GCT_SIM8060-6-0-14-00; MPN SIM8060-6-0-14-00-A; LCSC C6296715
J402: U.FL LTE main; U.FL_Hirose_U.FL-R-SMT-1_Vertical; MPN U.FL-R-SMT-1(10); LCSC C88373
J403: U.FL GNSS; U.FL_Hirose_U.FL-R-SMT-1_Vertical; MPN U.FL-R-SMT-1(10); LCSC C88373
L401: 27nH; L_0402_1005Metric; MPN LQG15HS27NJ02D; LCSC C12669
Q401, Q402: MMBT3904; SOT-23; MPN MMBT3904; LCSC C20526
R401, R403: 4.7k; R_0603_1608Metric
R402, R404: 47k; R_0603_1608Metric
R405, R406, R407, R411, R412, R413: 22R; R_0402_1005Metric
R408: 15k; R_0402_1005Metric
R409: 0R; R_0402_1005Metric
R414: 100k; R_0402_1005Metric
R415: 232k; R_0402_1005Metric
TP401: LTE_USB_VBUS; TestPoint_Pad_D1.0mm
TP402: LTE_USB_DP; TestPoint_Pad_D1.0mm
TP403: LTE_USB_DM; TestPoint_Pad_D1.0mm
TP404: LTE_USB_BOOT; TestPoint_Pad_D1.0mm
TP405: LTE_DBG_TXD; TestPoint_Pad_D1.0mm
TP406: LTE_DBG_RXD; TestPoint_Pad_D1.0mm
TP407: LTE_1V8; TestPoint_Pad_D1.0mm
U401: EC200U-EU; Quectel_EC200U; MPN EC200UEUAA-N05-SGNSA; LCSC C2942341
U402: TXS0108EPW; TSSOP-20_4.4x6.5mm_P0.65mm; MPN TXS0108EPWR; LCSC C17206
U403: eSIM MFF2; WSON-8-1EP_6x5mm_P1.27mm_EP3.4x4mm; MPN MFF2 eSIM, optional (DNP); not fitted
U404: FSA2567UMX; UQFN-16_1.8x2.6mm_P0.4mm; MPN FSA2567UMX; LCSC C357761
U405: TPS2552DBVR-1; SOT-23-6; MPN TPS2552DBVR-1; LCSC C140331

Connections:
+3V3: C406.1, C416.1, C420.1, U402.19 (VCCB), U404.14 (VCC), U405.1 (IN); also elsewhere on the board
/LTE + GNSS (EC200U)/LTE_ANT_GNSS: C413.1, C417.1, U401.47 (ANT_GNSS)
/LTE + GNSS (EC200U)/LTE_ANT_GNSS_UFL: C414.1, C417.2, J403.1 (In), L401.2
/LTE + GNSS (EC200U)/LTE_ANT_MAIN: C411.1, R409.1, U401.49 (ANT_MAIN)
/LTE + GNSS (EC200U)/LTE_CTS_1V8: U401.64 (CTS), U402.5 (A4)
/LTE + GNSS (EC200U)/LTE_DBG_RXD: TP406.1, U401.11 (DBG_RXD)
/LTE + GNSS (EC200U)/LTE_DBG_TXD: TP405.1, U401.12 (DBG_TXD)
/LTE + GNSS (EC200U)/LTE_PWRKEY: Q401.3 (C), U401.21 (PWRKEY)
/LTE + GNSS (EC200U)/LTE_RESET_N: Q402.3 (C), U401.20 (RESET_N)
/LTE + GNSS (EC200U)/LTE_RTS_1V8: U401.65 (RTS), U402.4 (A3)
/LTE + GNSS (EC200U)/LTE_RXD_1V8: U401.68 (RXD), U402.1 (A1)
/LTE + GNSS (EC200U)/LTE_STATUS: U401.61 (STATUS), U402.6 (A5)
/LTE + GNSS (EC200U)/LTE_TXD_1V8: U401.67 (TXD), U402.3 (A2)
/LTE + GNSS (EC200U)/LTE_USB_BOOT: TP404.1, U401.115 (USB_BOOT)
/LTE + GNSS (EC200U)/LTE_USB_DM: TP403.1, U401.70 (USB_DM)
/LTE + GNSS (EC200U)/LTE_USB_DP: TP402.1, U401.69 (USB_DP)
/LTE + GNSS (EC200U)/LTE_USB_VBUS: TP401.1, U401.71 (USB_VBUS)
/LTE + GNSS (EC200U)/LTE_USIM_CLK: U401.16 (USIM_CLK), U404.8 (CLK)
/LTE + GNSS (EC200U)/LTE_USIM_DATA: R408.2, U401.15 (USIM_DATA), U404.12 (DAT)
/LTE + GNSS (EC200U)/LTE_USIM_RST: U401.17 (USIM_RST), U404.4 (RST)
/LTE + GNSS (EC200U)/SIM1_CLK: R406.1, U404.9 (1CLK)
/LTE + GNSS (EC200U)/SIM1_DAT: R405.1, U404.13 (1DAT)
/LTE + GNSS (EC200U)/SIM1_RST: R407.1, U404.5 (1RST)
/LTE + GNSS (EC200U)/SIM1_VDD: C410.1, J401.1 (VCC), U404.1 (1VSIM)
/LTE + GNSS (EC200U)/SIM2_CLK: R412.1, U404.7 (2CLK)
/LTE + GNSS (EC200U)/SIM2_DAT: R411.1, U404.11 (2DAT)
/LTE + GNSS (EC200U)/SIM2_RST: R413.1, U404.3 (2RST)
/LTE + GNSS (EC200U)/SIM2_VDD: C415.1, U403.8 (VCC), U404.15 (2VSIM)
/LTE + GNSS (EC200U)/SIM_CLK: C408.1, J401.3 (CLK), R406.2
/LTE + GNSS (EC200U)/SIM_IO: C407.1, J401.7 (I/O), R405.2
/LTE + GNSS (EC200U)/SIM_RST: C409.1, J401.2 (RST), R407.2
/LTE + GNSS (EC200U)/SIM_VDD: R408.1, U401.14 (USIM_VDD), U404.16 (VSIM)
GND: C401.2, C402.2, C403.2, C404.2, C405.2, C406.2, C407.2, C408.2, C409.2, C410.2, C411.2, C412.2, C413.2, C414.2, C415.2, C416.2, C418.2, C419.2, C420.2, J401.5 (GND), J402.2 (Ext), J403.2 (Ext), Q401.2 (E), Q402.2 (E), R402.2, R404.2, R414.2, R415.2, U401.8 (GND), U401.9 (GND), U401.10 (USIM_GND), U401.19 (GND), U401.22 (GND), U401.36 (GND), U401.46 (GND), U401.48 (GND), U401.50 (GND), U401.51 (GND), U401.52 (GND), U401.53 (GND), U401.54 (GND), U401.56 (GND), U401.72 (GND), U401.76 (GND), U401.85 (GND), U401.86 (GND), U401.87 (GND), U401.88 (GND), U401.89 (GND), U401.90 (GND), U401.91 (GND), U401.92 (GND), U401.93 (GND), U401.94 (GND), U401.95 (GND), U401.96 (GND), U401.97 (GND), U401.98 (GND), U401.99 (GND), U401.100 (GND), U401.101 (GND), U401.102 (GND), U401.103 (GND), U401.104 (GND), U401.105 (GND), U401.106 (GND), U401.107 (GND), U401.108 (GND), U401.109 (GND), U401.110 (GND), U401.111 (GND), U401.112 (GND), U402.11 (GND), U403.1 (GND), U404.6 (GND), U405.2 (GND); also elsewhere on the board
LTE_1V8: C405.1, TP407.1, U401.7 (VDD_EXT), U402.2 (VCCA), U402.10 (OE)
LTE_PWRKEY_CTL: R401.1; also elsewhere on the board
LTE_PWR_ON_N: U405.3 (~EN); also elsewhere on the board
LTE_RESET_CTL: R403.1; also elsewhere on the board
LTE_STATUS_3V3: U402.15 (B5); also elsewhere on the board
MCU_CTS_LTE: U402.16 (B4); also elsewhere on the board
MCU_RTS_LTE: U402.17 (B3); also elsewhere on the board
MCU_RX_LTE: U402.18 (B2); also elsewhere on the board
MCU_TX_LTE: U402.20 (B1); also elsewhere on the board
unnamed: C412.1, J402.1 (In), R409.2
unnamed: Q401.1 (B), R401.2, R402.1
unnamed: Q402.1 (B), R403.2, R404.1
unnamed: R412.2, U403.6 (CLK)
unnamed: R411.2, U403.3 (I/O)
unnamed: R413.2, U403.7 (RST)
unnamed: R415.1, U405.5 (ILIM)
unnamed: C418.1, C419.1, L401.1, U405.6 (OUT)
SIM_SEL: R414.1, U404.2 (Sel); also elsewhere on the board
VBAT_LTE: C401.1, C402.1, C403.1, C404.1, U401.57 (VBAT_RF), U401.58 (VBAT_RF), U401.59 (VBAT_BB), U401.60 (VBAT_BB); also elsewhere on the board

Notes on the sheet:
SIM 1 = nano-SIM J401 (default)
PWRKEY / RESET_N open-collector drivers (MCU high = pull low)
Test pads: modem USB (firmware update), debug UART
VBAT_LTE bulk/decoupling (close to pins 57-60)
1.8 V <-> 3.3 V level shifter (disabled while modem is off)
Antennas (pi-match, shunt caps DNP until tuned)
GNSS antenna bias (active + passive antennas) 3.3 V while the modem is on; latch-off 100-137 mA
SIM switch: SIM_SEL low (default) = nano-SIM J401, high = eSIM U403
SIM 2 = soldered eSIM U403 (fit an MFF2 eUICC)

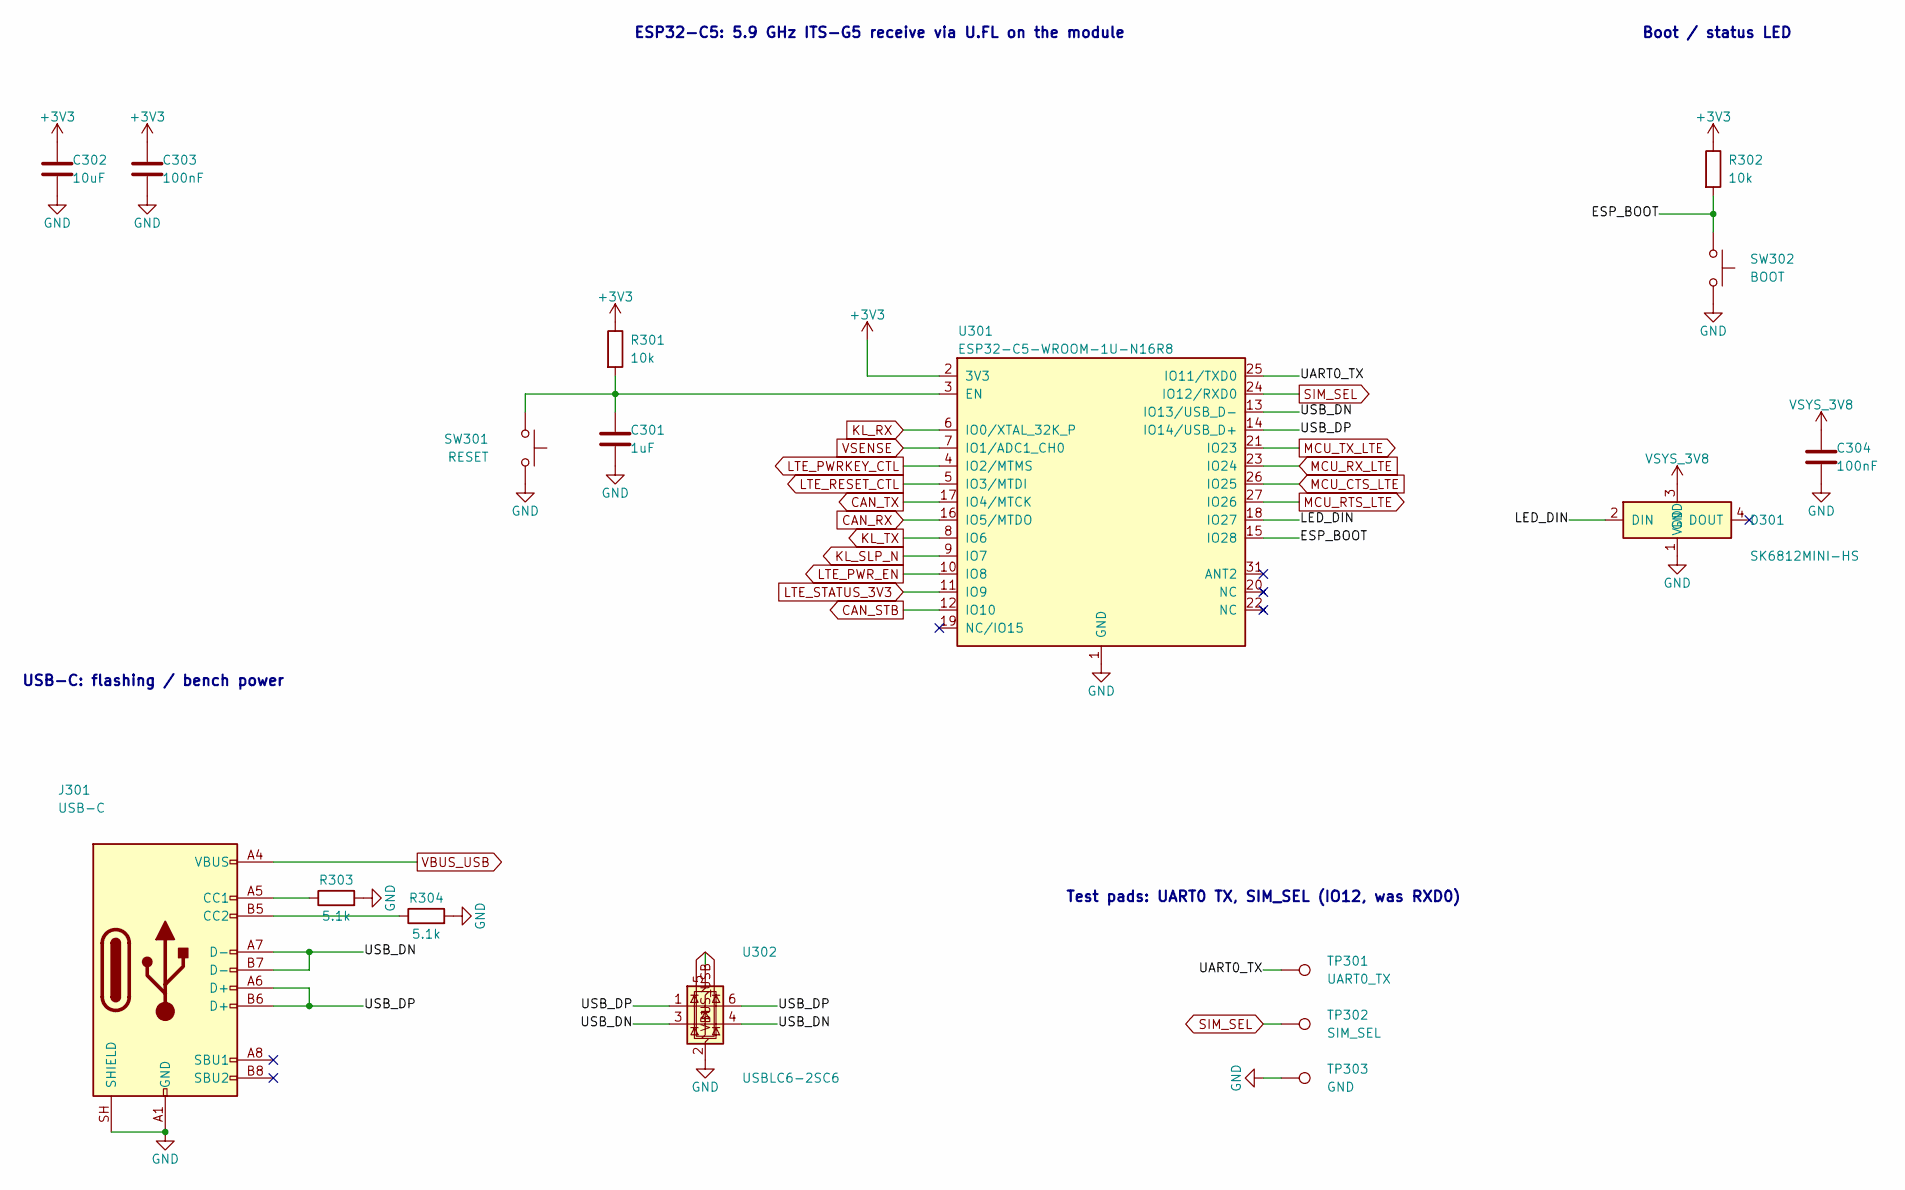
[picture p18: schematic mcu.kicad_sch, MCU: ESP32-C5 (ITS-G5 RX, CAN FD, BLE), USB-C]

Parts:
C301: 1uF; C_0603_1608Metric
C302: 10uF; C_0805_2012Metric
C303, C304: 100nF; C_0603_1608Metric
D301: SK6812MINI-HS; LED_SK6812MINI-HS_3.7x3.5mm; MPN SK6812MINI-HS; LCSC C2922787
J301: USB-C; USB_C_Receptacle_HRO_TYPE-C-31-M-12; MPN TYPE-C-31-M-12; LCSC C165948
R301, R302: 10k; R_0603_1608Metric
R303, R304: 5.1k; R_0603_1608Metric
SW301: RESET; SW_SPST_TL3342; MPN TL3342F450QG; LCSC C2886897
SW302: BOOT; SW_SPST_TL3342; MPN TL3342F450QG; LCSC C2886897
TP301: UART0_TX; TestPoint_Pad_D1.0mm
TP302: SIM_SEL; TestPoint_Pad_D1.0mm
TP303: GND; TestPoint_Pad_D1.0mm
U301: ESP32-C5-WROOM-1U-N16R8; ESP32-C5-WROOM-1U; MPN ESP32-C5-WROOM-1U-N16R8-V1.2; LCSC C54951857
U302: USBLC6-2SC6; SOT-23-6; MPN USBLC6-2SC6; LCSC C2827654

Connections:
+3V3: C302.1, C303.1, R301.1, R302.1, U301.2 (3V3); also elsewhere on the board
/MCU (ESP32-C5, USB)/ESP_BOOT: R302.2, SW302.1, U301.15 (IO28)
/MCU (ESP32-C5, USB)/LED_DIN: D301.2 (DIN), U301.18 (IO27)
/MCU (ESP32-C5, USB)/UART0_TX: TP301.1, U301.25 (IO11/TXD0)
/MCU (ESP32-C5, USB)/USB_DN: J301.A7 (D-), J301.B7 (D-), U301.13 (IO13/USB_D-), U302.3 (I/O2), U302.4 (I/O2)
/MCU (ESP32-C5, USB)/USB_DP: J301.A6 (D+), J301.B6 (D+), U301.14 (IO14/USB_D+), U302.1 (I/O1), U302.6 (I/O1)
CAN_RX: U301.16 (IO5/MTDO); also elsewhere on the board
CAN_STB: U301.12 (IO10); also elsewhere on the board
CAN_TX: U301.17 (IO4/MTCK); also elsewhere on the board
GND: C301.2, C302.2, C303.2, C304.2, D301.1 (GND), J301.A1 (GND), J301.A12 (GND), J301.B1 (GND), J301.B12 (GND), J301.SH (SHIELD), R303.2, R304.2, SW301.2, SW302.2, TP303.1, U301.1 (GND), U301.28 (GND), U301.29 (GND), U301.30 (GND), U301.32 (GND), U302.2 (GND); also elsewhere on the board
KL_RX: U301.6 (IO0/XTAL_32K_P); also elsewhere on the board
KL_SLP_N: U301.9 (IO7); also elsewhere on the board
KL_TX: U301.8 (IO6); also elsewhere on the board
LTE_PWRKEY_CTL: U301.4 (IO2/MTMS); also elsewhere on the board
LTE_PWR_EN: U301.10 (IO8); also elsewhere on the board
LTE_RESET_CTL: U301.5 (IO3/MTDI); also elsewhere on the board
LTE_STATUS_3V3: U301.11 (IO9); also elsewhere on the board
MCU_CTS_LTE: U301.26 (IO25); also elsewhere on the board
MCU_RTS_LTE: U301.27 (IO26); also elsewhere on the board
MCU_RX_LTE: U301.23 (IO24); also elsewhere on the board
MCU_TX_LTE: U301.21 (IO23); also elsewhere on the board
unnamed: J301.A5 (CC1), R303.1
unnamed: J301.B5 (CC2), R304.1
unnamed: C301.1, R301.2, SW301.1, U301.3 (EN)
SIM_SEL: TP302.1, U301.24 (IO12/RXD0); also elsewhere on the board
VBUS_USB: J301.A4 (VBUS), J301.A9 (VBUS), J301.B4 (VBUS), J301.B9 (VBUS), U302.5 (VBUS); also elsewhere on the board
VSENSE: U301.7 (IO1/ADC1_CH0); also elsewhere on the board
VSYS_3V8: C304.1, D301.3 (VDD); also elsewhere on the board

Notes on the sheet:
Test pads: UART0 TX, SIM_SEL (IO12, was RXD0)
USB-C: flashing / bench power
ESP32-C5: 5.9 GHz ITS-G5 receive via U.FL on the module
Boot / status LED

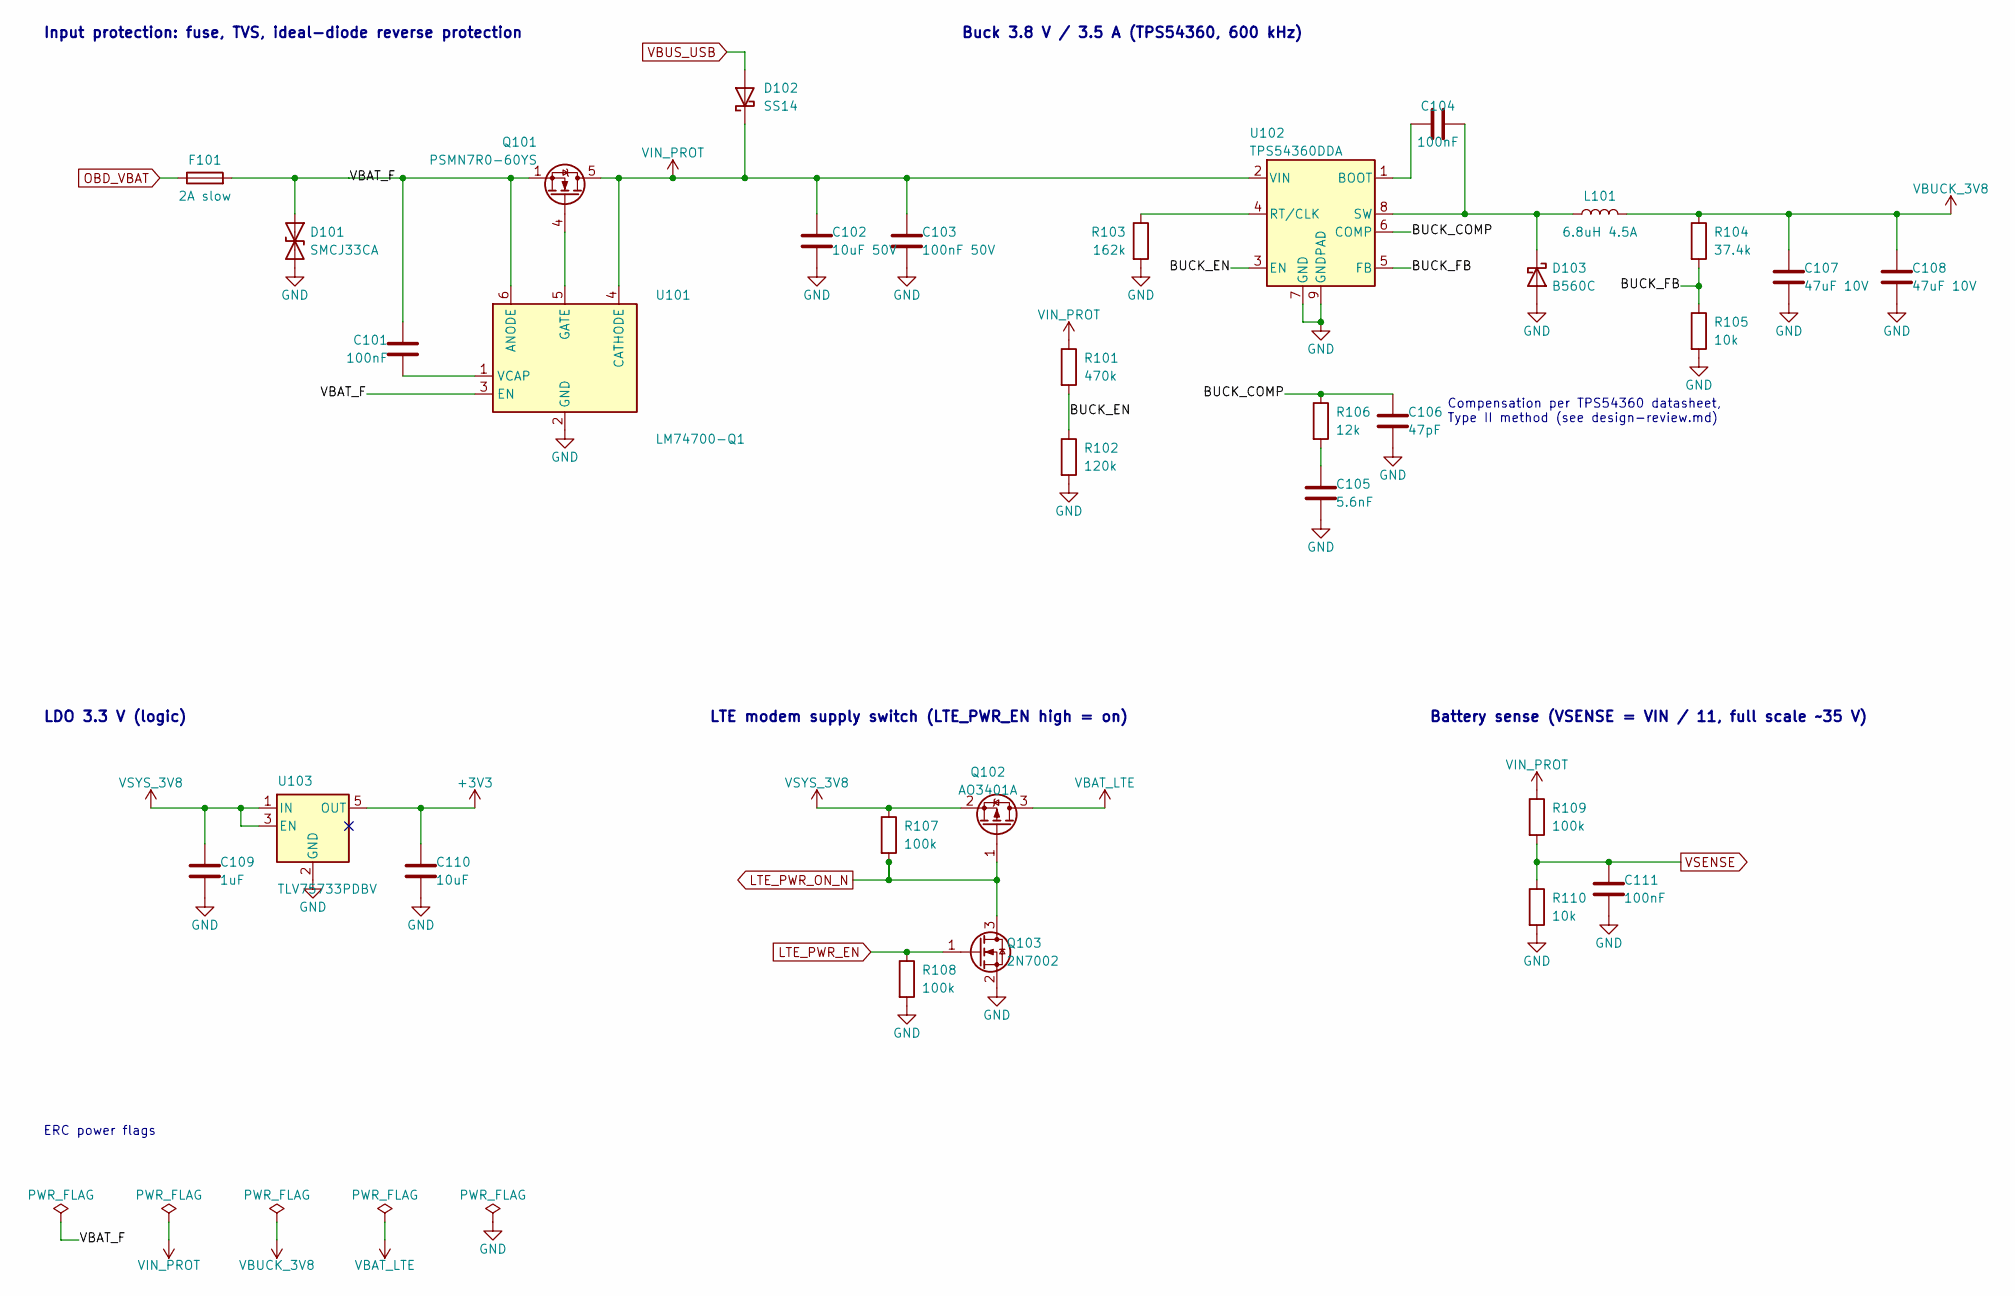
[picture p19: schematic power.kicad_sch, Power: protection, buck 3.8 V, LDO 3.3 V]

Parts:
C101, C104, C111: 100nF; C_0603_1608Metric
C102: 10uF 50V; C_1210_3225Metric
C103: 100nF 50V; C_0603_1608Metric
C105: 5.6nF; C_0603_1608Metric
C106: 47pF; C_0603_1608Metric
C107, C108: 47uF 10V; C_1210_3225Metric
C109: 1uF; C_0603_1608Metric
C110: 10uF; C_0805_2012Metric
D101: SMCJ33CA; D_SMC; MPN SMCJ33CA; LCSC C310048
D102: SS14; D_SMA; MPN SS14; LCSC C2480
D103: B560C; D_SMC; MPN B560C-13-F; LCSC C85100
F101: 2A slow; Fuse_1206_3216Metric; MPN 0466002.NRHF; LCSC C3105
L101: 6.8uH 4.5A; L_Sunlord_MWSA0605S; MPN MWSA0605S-6R8MT; LCSC C408466
Q101: PSMN7R0-60YS; LFPAK56; MPN PSMN7R0-60YS,115; LCSC C478143
Q102: AO3401A; SOT-23; MPN AO3401A; LCSC C15127
Q103: 2N7002; SOT-23; MPN 2N7002; LCSC C8545
R101: 470k; R_0603_1608Metric
R102: 120k; R_0603_1608Metric
R103: 162k; R_0603_1608Metric
R104: 37.4k; R_0603_1608Metric
R105, R110: 10k; R_0603_1608Metric
R106: 12k; R_0603_1608Metric
R107, R108, R109: 100k; R_0603_1608Metric
U101: LM74700-Q1; SOT-23-6; MPN LM74700QDBVRQ1; LCSC C2941042
U102: TPS54360DDA; TI_SO-PowerPAD-8_ThermalVias; MPN TPS54360DDAR; LCSC C44377
U103: TLV75733PDBV; SOT-23-5; MPN TLV75733PDBVR; LCSC C485517

Connections:
+3V3: C110.1, U103.5 (OUT); also elsewhere on the board
/Power/BUCK_COMP: C106.1, R106.1, U102.6 (COMP)
/Power/BUCK_EN: R101.2, R102.1, U102.3 (EN)
/Power/BUCK_FB: R104.2, R105.1, U102.5 (FB)
/Power/VBAT_F: C101.2, D101.1 (A1), F101.2, Q101.1 (S), Q101.2 (S), Q101.3 (S), U101.3 (EN), U101.6 (ANODE)
GND: C102.2, C103.2, C105.2, C106.2, C107.2, C108.2, C109.2, C110.2, C111.2, D101.2 (A2), D103.2 (A), Q103.2 (S), R102.2, R103.2, R105.2, R108.2, R110.2, U101.2 (GND), U102.7 (GND), U102.9 (GNDPAD), U103.2 (GND); also elsewhere on the board
LTE_PWR_EN: Q103.1 (G), R108.1; also elsewhere on the board
LTE_PWR_ON_N: Q102.1 (G), Q103.3 (D), R107.2; also elsewhere on the board
unnamed: C105.1, R106.2
unnamed: C104.2, D103.1 (K), L101.1, U102.8 (SW)
unnamed: Q101.4 (G), U101.5 (GATE)
unnamed: C101.1, U101.1 (VCAP)
unnamed: C104.1, U102.1 (BOOT)
unnamed: R103.1, U102.4 (RT/CLK)
OBD_VBAT: F101.1; also elsewhere on the board
VBAT_LTE: Q102.3 (D); also elsewhere on the board
VBUCK_3V8: C107.1, C108.1, L101.2, R104.1; also elsewhere on the board
VBUS_USB: D102.2 (A); also elsewhere on the board
VIN_PROT: C102.1, C103.1, D102.1 (K), Q101.5 (D), R101.1, R109.1, U101.4 (CATHODE), U102.2 (VIN); also elsewhere on the board
VSENSE: C111.1, R109.2, R110.1; also elsewhere on the board
VSYS_3V8: C109.1, Q102.2 (S), R107.1, U103.1 (IN), U103.3 (EN); also elsewhere on the board

Notes on the sheet:
LTE modem supply switch (LTE_PWR_EN high = on)
ERC power flags
Compensation per TPS54360 datasheet, Type II method (see design-review.md)
LDO 3.3 V (logic)
Buck 3.8 V / 3.5 A (TPS54360, 600 kHz)
Input protection: fuse, TVS, ideal-diode reverse protection
Battery sense (VSENSE = VIN / 11, full scale ~35 V)

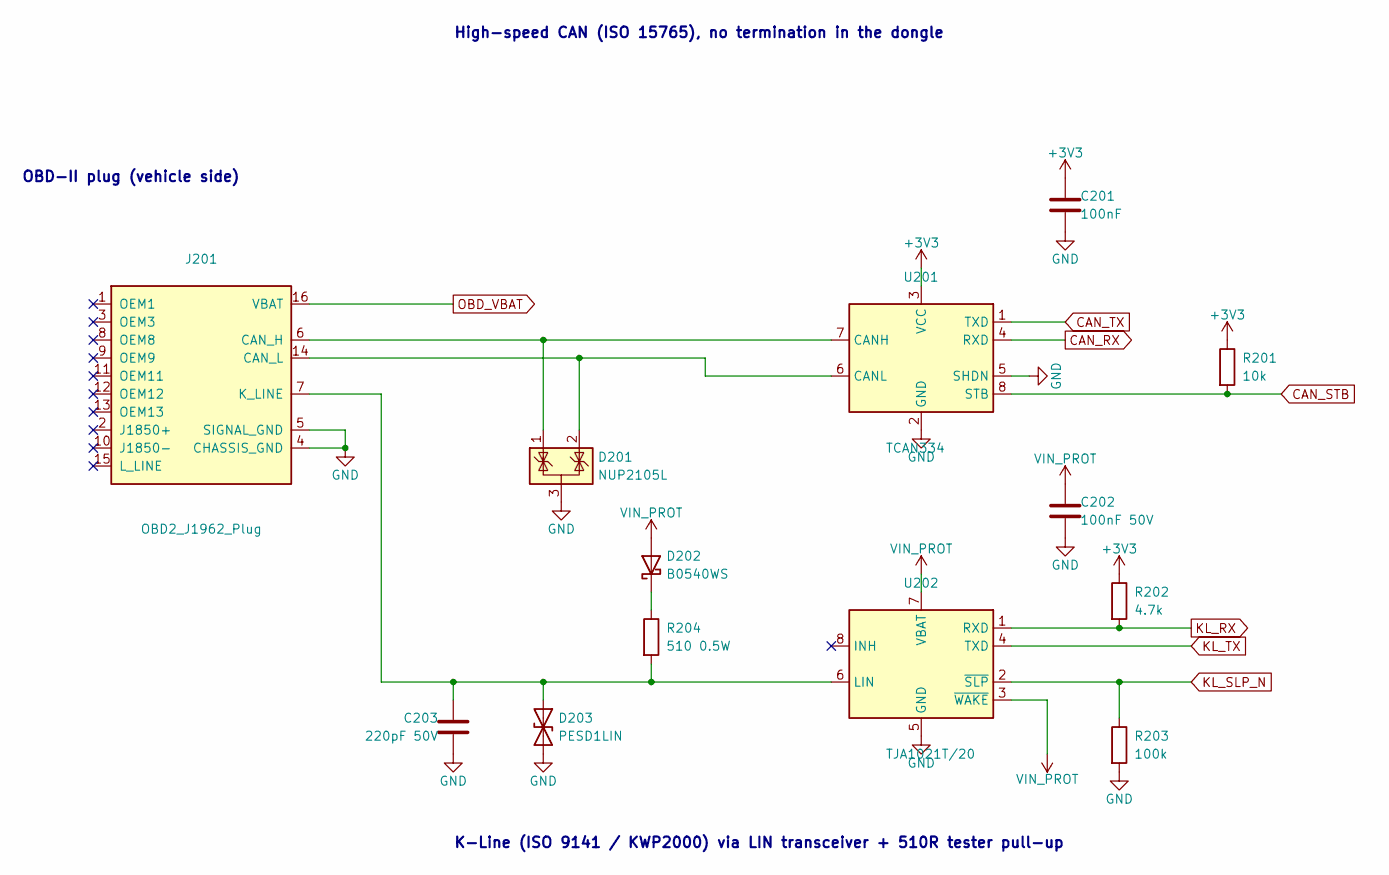
[picture p20: schematic vehicle.kicad_sch, Vehicle interface: OBD-II, CAN, K-Line]

Parts:
C201: 100nF; C_0603_1608Metric
C202: 100nF 50V; C_0603_1608Metric
C203: 220pF 50V; C_0603_1608Metric
D201: NUP2105L; SOT-23; MPN SZNUP2105LT1G; LCSC C233494
D202: B0540WS; D_SOD-323; MPN B0540WS-7; LCSC C52754523
D203: PESD1LIN; D_SOD-323; MPN PESD1LIN,115; LCSC C58901
J201: OBD2_J1962_Plug; OBD2_J1962_Plug_PCB; MPN CR-PG001 (OBD2 male 90deg PCB, hand-fit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
R201: 10k; R_0603_1608Metric
R202: 4.7k; R_0603_1608Metric
R203: 100k; R_0603_1608Metric
R204: 510 0.5W; R_1206_3216Metric
U201: TCAN334; SOIC-8_3.9x4.9mm_P1.27mm; MPN TCAN334DR; LCSC C2871143
U202: TJA1021T/20; SOIC-8_3.9x4.9mm_P1.27mm; MPN TJA1021T/20/CM,118; LCSC C128810

Connections:
+3V3: C201.1, R201.1, R202.1, U201.3 (VCC); also elsewhere on the board
CAN_RX: U201.4 (RXD); also elsewhere on the board
CAN_STB: R201.2, U201.8 (STB); also elsewhere on the board
CAN_TX: U201.1 (TXD); also elsewhere on the board
GND: C201.2, C202.2, C203.2, D201.3 (A), D203.2 (A2), J201.4 (CHASSIS_GND), J201.5 (SIGNAL_GND), R203.2, U201.2 (GND), U201.5 (SHDN), U202.5 (GND); also elsewhere on the board
KL_RX: R202.2, U202.1 (RXD); also elsewhere on the board
KL_SLP_N: R203.1, U202.2 (~SLP); also elsewhere on the board
KL_TX: U202.4 (TXD); also elsewhere on the board
unnamed: D202.1 (K), R204.1
unnamed: C203.1, D203.1 (A1), J201.7 (K_LINE), R204.2, U202.6 (LIN)
unnamed: D201.1 (K), J201.6 (CAN_H), U201.7 (CANH)
unnamed: D201.2 (K), J201.14 (CAN_L), U201.6 (CANL)
OBD_VBAT: J201.16 (VBAT); also elsewhere on the board
VIN_PROT: C202.1, D202.2 (A), U202.3 (~WAKE), U202.7 (VBAT); also elsewhere on the board

Notes on the sheet:
High-speed CAN (ISO 15765), no termination in the dongle
OBD-II plug (vehicle side)
K-Line (ISO 9141 / KWP2000) via LIN transceiver + 510R tester pull-up

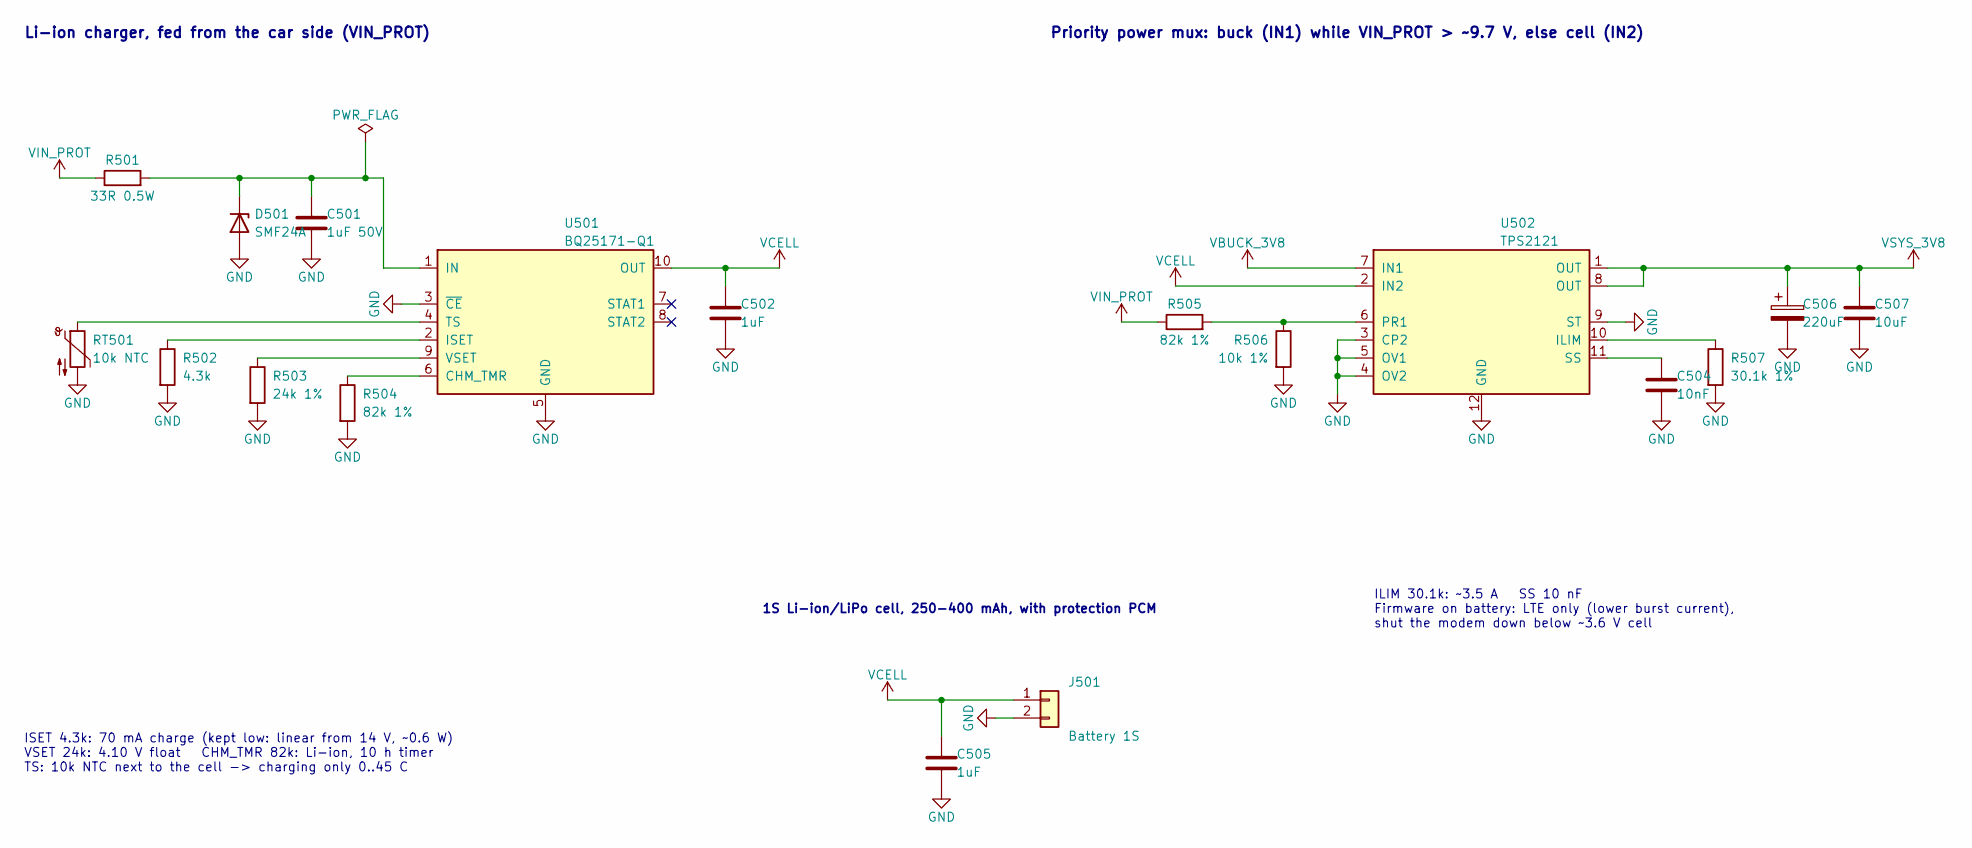
[picture p21: schematic battery.kicad_sch, Backup battery: 1S Li-ion charger (BQ25171-Q1) + priority p…]

Parts:
C501: 1uF 50V; C_0805_2012Metric
C502, C505: 1uF; C_0603_1608Metric
C504: 10nF; C_0603_1608Metric
C506: 220uF; CP_EIA-7343-31_Kemet-D; MPN T495D227K006ATE100; LCSC C2798131
C507: 10uF; C_0805_2012Metric
D501: SMF24A; D_SOD-123F; MPN SMF24A; LCSC C315999
J501: Battery 1S; JST_PH_B2B-PH-SM4-TB_1x02-1MP_P2.00mm_Vertical; MPN B2B-PH-SM4-TB(LF)(SN); LCSC C160352
R501: 33R 0.5W; R_1206_3216Metric
R502: 4.3k; R_0603_1608Metric
R503: 24k 1%; R_0603_1608Metric
R504, R505: 82k 1%; R_0603_1608Metric
R506: 10k 1%; R_0603_1608Metric
R507: 30.1k 1%; R_0603_1608Metric
RT501: 10k NTC; R_0603_1608Metric; MPN SDNT1608X103F3435FTF; LCSC C525660
U501: BQ25171-Q1; Texas_DRC0010J; MPN BQ25171QWDRCRQ1; LCSC C2861221
U502: TPS2121; Texas_VQFN-HR-12_2x2.5mm_P0.5mm; MPN TPS2121RUXR; LCSC C485916

Connections:
GND: C501.2, C502.2, C504.2, C505.2, C506.2, C507.2, D501.2 (A), J501.2, R502.2, R503.2, R504.2, R506.2, R507.2, RT501.2, U501.3 (~CE), U501.5 (GND), U501.11 (GND), U502.3 (CP2), U502.4 (OV2), U502.5 (OV1), U502.9 (ST), U502.12 (GND); also elsewhere on the board
unnamed: C501.1, D501.1 (K), R501.2, U501.1 (IN)
unnamed: R504.1, U501.6 (CHM_TMR)
unnamed: R502.1, U501.2 (ISET)
unnamed: RT501.1, U501.4 (TS)
unnamed: R503.1, U501.9 (VSET)
unnamed: R507.1, U502.10 (ILIM)
unnamed: R505.2, R506.1, U502.6 (PR1)
unnamed: C504.1, U502.11 (SS)
VBUCK_3V8: U502.7 (IN1); also elsewhere on the board
VCELL: C502.1, C505.1, J501.1, U501.10 (OUT), U502.2 (IN2)
VIN_PROT: R501.1, R505.1; also elsewhere on the board
VSYS_3V8: C506.1, C507.1, U502.1 (OUT), U502.8 (OUT); also elsewhere on the board

Notes on the sheet:
ILIM 30.1k: ~3.5 A SS 10 nF Firmware on battery: LTE only (lower burst current), shut the modem down below ~3.6 V cell
Li-ion charger, fed from the car side (VIN_PROT)
ISET 4.3k: 70 mA charge (kept low: linear from 14 V, ~0.6 W) VSET 24k: 4.10 V float CHM_TMR 82k: Li-ion, 10 h timer TS: 10k NTC next to the cell -> charging only 0..45 C
1S Li-ion/LiPo cell, 250-400 mAh, with protection PCM
Priority power mux: buck (IN1) while VIN_PROT > ~9.7 V, else cell (IN2)

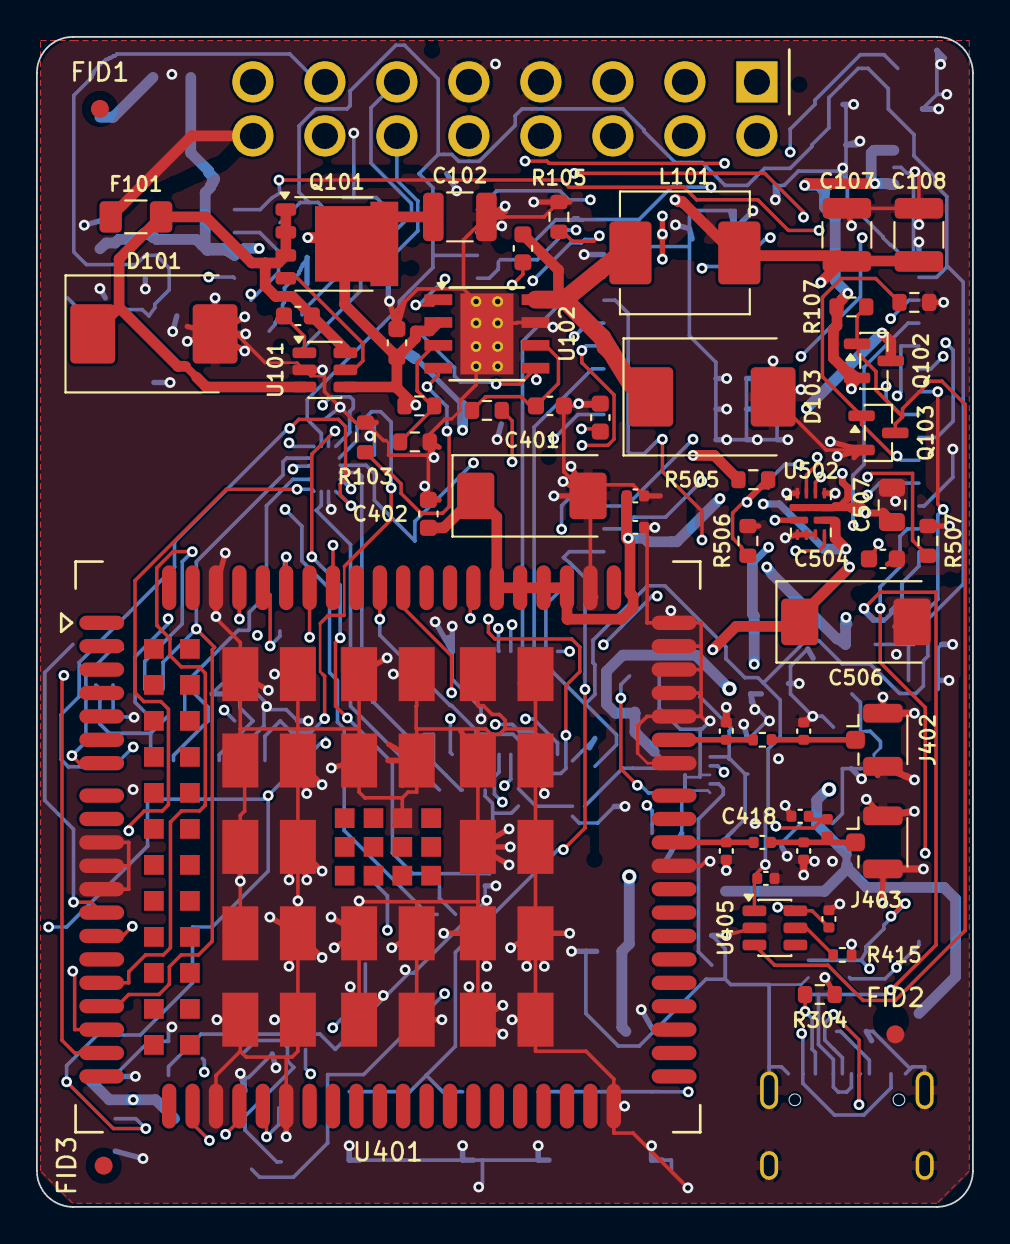
[picture p22: board obd-v2x-dongle.kicad_pcb from above]

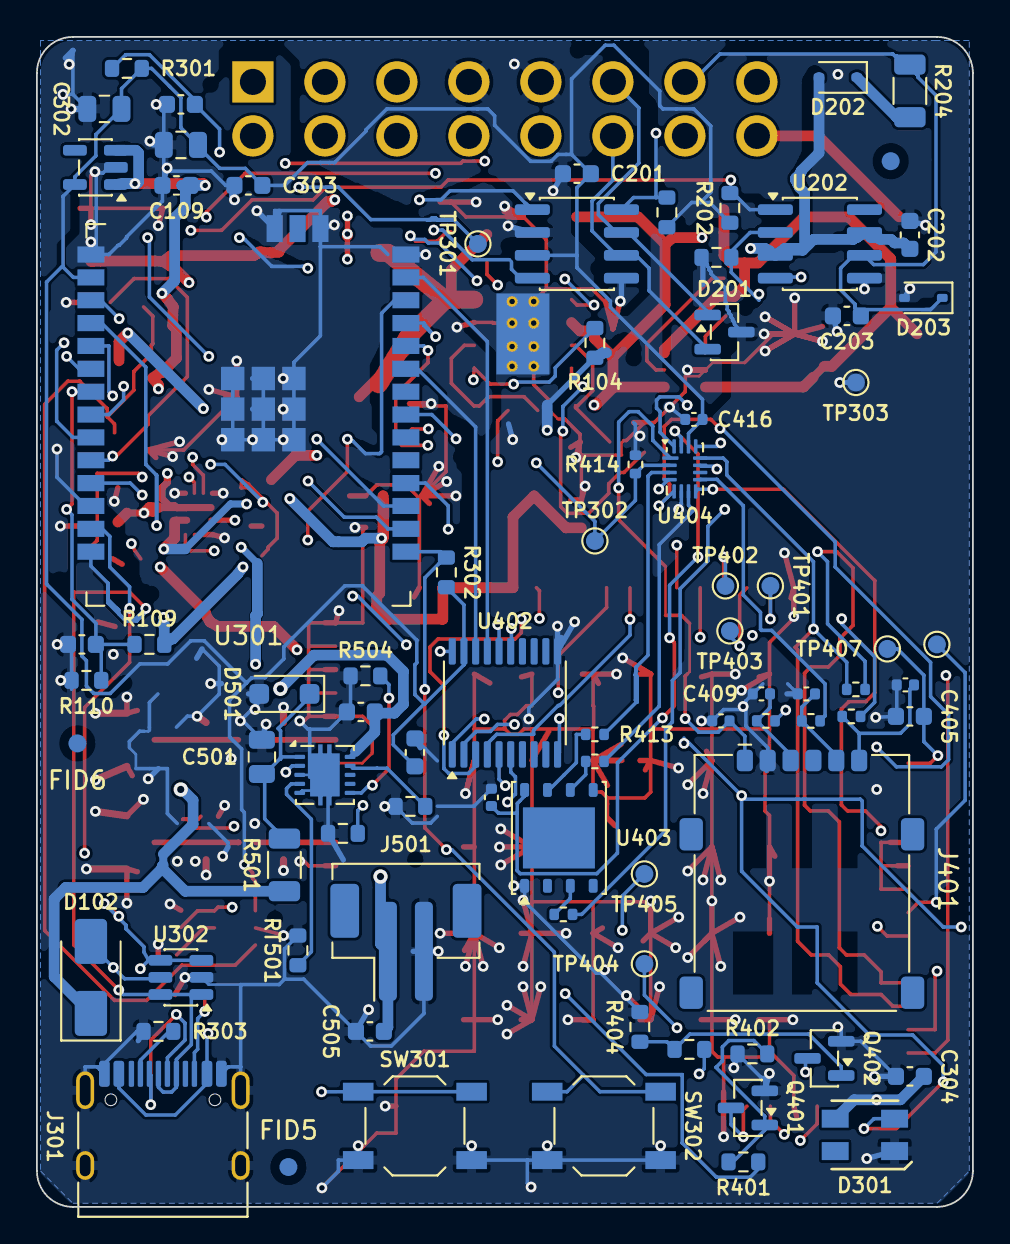
[picture p23: board obd-v2x-dongle.kicad_pcb from below]

Board: 4 copper layers, 52.0 x 65.0 mm, 138 parts (83 on the bottom side), 96 nets.

Other parts of the board:
FID1, FID2, FID3, FID4, FID5, FID6: Fiducial; Fiducial_1mm_Mask2mm
