peterbaumert/obd-v2x-dongle/firmware/components/obd2/obd2.h

#pragma once

#include <atomic>
#include <cmath>
#include <string>
#include <vector>

#include <esp_twai.h>
#include <esp_twai_onchip.h>
#include <freertos/FreeRTOS.h>
#include <freertos/queue.h>

#include "esphome/components/binary_sensor/binary_sensor.h"
#include "esphome/components/button/button.h"
#include "esphome/components/select/select.h"
#include "esphome/components/sensor/sensor.h"
#include "esphome/components/text_sensor/text_sensor.h"
#include "esphome/core/component.h"
#include "esphome/core/hal.h"
#include "esphome/core/helpers.h"
#include "esphome/core/preferences.h"

namespace esphome::obd2 {

struct RxFrame {
  uint32_t id;
  uint8_t len;
  uint8_t data[8];
};

/// One broadcast field of a vehicle profile (firmware/vehicles/*.json, compiled in by profiles.py).
enum class SignalKind : uint8_t { NUMBER, FLAG, ENUM };
struct EnumValue {
  uint32_t raw;
  const char *name;
  bool on;  // this state counts as "on" for a binary sensor
};
struct SignalDef {
  uint16_t can_id;
  uint8_t signal;  // index into the signal catalog (shared by all profiles)
  SignalKind kind;
  uint8_t start;
  uint8_t len;
  bool little;
  uint32_t mask;  // flag: bit(s) to test; enum: bits that belong to the field (0 = all)
  float scale;
  float offset;
  std::vector<uint32_t> invalid;
  std::vector<EnumValue> values;
};
struct Profile {
  const char *title;
  std::vector<SignalDef> defs;
};

/// OBD-II over CAN (ISO 15765-4, 11-bit) on the TWAI node driver: mode 01 live data, VIN (09/02),
/// stored fault codes (03) and clearing them (04). Multi-frame (ISO-TP) responses are reassembled per ECU.
class Obd2Component : public Component {
 public:
  void set_pins(int tx, int rx) {
    this->tx_pin_ = tx;
    this->rx_pin_ = rx;
  }
  void set_bit_rate(uint32_t bit_rate) { this->bit_rate_ = bit_rate; }
  void set_poll_interval(uint32_t ms) { this->poll_interval_ = ms; }
  void set_dtc_interval(uint32_t ms) { this->dtc_interval_ = ms; }
  void set_standby_pin(GPIOPin *pin) { this->standby_pin_ = pin; }
  void add_pid(uint8_t pid, sensor::Sensor *sens, bool fast);
  void set_vin_sensor(text_sensor::TextSensor *s) { this->vin_sensor_ = s; }
  void set_dtc_sensor(text_sensor::TextSensor *s) { this->dtc_sensor_ = s; }
  void set_dtc_count_sensor(sensor::Sensor *s) { this->dtc_count_sensor_ = s; }
  void set_listen_after_stop(uint32_t ms) { this->listen_after_stop_ = ms; }
  void set_signal_interval(uint32_t ms) { this->signal_interval_ = ms; }

  // Vehicle profiles (code generated from the JSON files): add_profile, then its signals
  void set_signal_count(size_t n) { this->outs_.resize(n); }
  void add_profile(const char *title) { this->profiles_.push_back({title, {}}); }
  void add_number(uint8_t signal, uint16_t can_id, uint8_t start, uint8_t len, bool little, float scale,
                  float offset);
  void add_flag(uint8_t signal, uint16_t can_id, uint8_t start, uint8_t mask);
  void add_enum(uint8_t signal, uint16_t can_id, uint8_t start, uint8_t len, bool little, uint32_t mask);
  void add_enum_value(uint32_t raw, const char *name, bool on);
  void add_invalid(uint32_t raw);
  void set_signal_sensor(uint8_t signal, sensor::Sensor *s) { this->outs_[signal].sensor = s; }
  void set_signal_binary_sensor(uint8_t signal, binary_sensor::BinarySensor *s) { this->outs_[signal].binary = s; }
  void set_signal_text_sensor(uint8_t signal, text_sensor::TextSensor *s) { this->outs_[signal].text = s; }
  /// Keep this signal's last value in flash (saved when the engine stops) and show it again after a reboot.
  void set_signal_restore(uint8_t signal) { this->outs_[signal].restore = true; }
  /// Active profile: index into the compiled profiles, -1 = none (OBD requests only).
  void set_profile(int index);
  int get_profile() const { return this->profile_; }

  void setup() override;
  void loop() override;
  void dump_config() override;
  float get_setup_priority() const override { return setup_priority::HARDWARE; }

  /// Start (true) or stop (false) talking on the bus; stopped = controller off, transceiver in standby.
  void set_active(bool active);
  bool is_active() const { return this->active_; }
  /// Mode 04: clear stored fault codes (only while active), then read them again.
  void clear_dtcs();

 protected:
  static constexpr size_t MAX_MSG = 128;
  static constexpr uint8_t NUM_ECUS = 8;  // 0x7E8..0x7EF
  static constexpr uint8_t TX_SLOTS = 4;

  enum class Pending : uint8_t { NONE, VIN, DTC, CLEAR };

  struct IsoTpRx {
    bool busy{false};
    uint16_t len{0};
    uint16_t got{0};
    uint8_t next_sn{0};
    uint8_t buf[MAX_MSG];
  };

  struct Pid {
    uint8_t pid;
    sensor::Sensor *sensor;
  };

  static bool on_rx_(twai_node_handle_t node, const twai_rx_done_event_data_t *edata, void *ctx);
  static bool on_tx_done_(twai_node_handle_t node, const twai_tx_done_event_data_t *edata, void *ctx);
  static bool on_state_(twai_node_handle_t node, const twai_state_change_event_data_t *edata, void *ctx);
  /// Last valid raw value as kept in flash (per signal, only for signals with restore)
  struct SavedRaw {
    int8_t profile;  // the profile it was decoded with: a raw value only means something in that profile
    uint8_t valid;
    uint32_t raw;
  };
  struct SignalOut {
    sensor::Sensor *sensor{nullptr};
    binary_sensor::BinarySensor *binary{nullptr};
    text_sensor::TextSensor *text{nullptr};
    bool known{false};
    uint32_t raw{0};
    float value{NAN};
    bool dirty{false};
    uint32_t last_pub{0};
    bool restore{false};
    bool save_dirty{false};
    SavedRaw saved{-1, 0, 0};
    ESPPreferenceObject pref;
  };

  bool send_(uint32_t id, const uint8_t *data, uint8_t len);
  bool request_(const uint8_t *payload, uint8_t len);
  void enable_node_();
  void disable_node_();
  void want_id_(uint32_t id) { this->want_ids_[id >> 5] |= 1u << (id & 31); }
  void decode_signals_(const RxFrame &f);
  void decode_(const SignalDef &def, const RxFrame &f);
  void apply_(const SignalDef &def, SignalOut &o, uint32_t raw);
  void publish_signals_(uint32_t now);
  void save_signals_();
  void handle_frame_(const RxFrame &frame);
  void handle_message_(uint8_t ecu, const uint8_t *d, uint16_t n);
  void handle_pid_(const uint8_t *d, uint16_t n);
  void finish_pending_();
  void poll_pid_();

  std::vector<Pid> pids_;
  std::vector<uint8_t> schedule_;  // indices into pids_, fast PIDs twice
  size_t next_{0};

  text_sensor::TextSensor *vin_sensor_{nullptr};
  text_sensor::TextSensor *dtc_sensor_{nullptr};
  sensor::Sensor *dtc_count_sensor_{nullptr};
  bool vin_known_{false};
  uint32_t last_vin_try_{0};
  bool want_dtc_{false};
  bool want_clear_{false};
  uint32_t last_dtc_{0};
  std::vector<std::string> dtcs_;
  bool dtc_replied_{false};
  Pending pending_{Pending::NONE};
  uint32_t pending_since_{0};

  int tx_pin_{-1};
  int rx_pin_{-1};
  uint32_t bit_rate_{500000};
  uint32_t poll_interval_{250};
  uint32_t dtc_interval_{300000};
  uint32_t last_poll_{0};
  GPIOPin *standby_pin_{nullptr};

  std::vector<Profile> profiles_;
  std::vector<SignalOut> outs_;
  int profile_{-1};
  uint32_t listen_after_stop_{180000};
  uint32_t signal_interval_{1000};
  uint32_t listen_until_{0};
  bool listening_{false};  // engine stopped, node still receiving (no requests)
  /// 11-bit IDs the ISR queues (OBD responses + the active profile's IDs), one bit per ID
  volatile uint32_t want_ids_[64]{};

  twai_node_handle_t node_{nullptr};
  QueueHandle_t rx_queue_{nullptr};
  bool node_enabled_{false};
  bool active_{false};
  std::atomic<uint8_t> tx_inflight_{0};
  std::atomic<bool> bus_off_{false};
  uint8_t tx_head_{0};
  uint8_t tx_buf_[TX_SLOTS][8]{};
  twai_frame_t tx_frame_[TX_SLOTS]{};
  IsoTpRx rx_[NUM_ECUS];
};

class ClearDtcButton : public button::Button, public Parented<Obd2Component> {
 protected:
  void press_action() override { this->parent_->clear_dtcs(); }
};

/// Option 0 = no profile, option n = compiled profile n-1; the choice is kept in flash.
class VehicleProfileSelect : public select::Select, public Component, public Parented<Obd2Component> {
 public:
  void set_initial_index(size_t index) { this->initial_ = index; }
  void setup() override {
    this->pref_ = this->make_entity_preference<size_t>();
    size_t index = this->initial_;
    size_t stored;
    if (this->pref_.load(&stored) && this->has_index(stored))
      index = stored;
    this->apply_(index);
  }
  float get_setup_priority() const override { return setup_priority::DATA; }

 protected:
  void control(size_t index) override {
    this->pref_.save(&index);
    this->apply_(index);
  }
  void apply_(size_t index) {
    this->parent_->set_profile(static_cast<int>(index) - 1);
    this->publish_state(index);
  }
  size_t initial_{0};
  ESPPreferenceObject pref_;
};

}  // namespace esphome::obd2
