peterbaumert/obd-v2x-dongle/(commit log)

2026-11-11 Initial KiCad project and README
    [obd-v2x-dongle.kicad_pcb, obd-v2x-dongle.kicad_sch]
2026-11-11 Schematic v0.1: power, vehicle (CAN/K-Line), ESP32-C5, EG25-G LTE
    - Generated project symbols (ESP32-C5-WROOM-1U, EG25-G, OBD2 J1962)
    - 60V buck + LM74700 ideal diode, 3.3V LDO, switched modem supply
    - TCAN334 CAN, TJA1021 K-Line, TXS0108E 1.8V/3.3V shifting
    - ERC: 0 errors (custom footprints still to do)
    - CLAUDE.md with PCBWay-first sourcing rule, BOM notes
    [lte.kicad_sch, mcu.kicad_sch, obd-v2x-dongle.kicad_sch, power.kicad_sch, vehicle.kicad_sch]
2026-11-11 Redraw schematic with clean wired layout (generated)
    - hardware/tools/gen_schematic.py generates all four sheets: real wires,
    GND/rail power symbols, global labels only between sheets
    - check_netlist.py verifies connectivity against the reviewed v0.1 netlist
    (112 nets identical); ERC 0 errors
    - Rail power symbols and reorganised OBD-II plug symbol in the project lib
    - Files saved in KiCad 10's latest format (no "older version" banner)
    [lte.kicad_sch, mcu.kicad_sch, obd-v2x-dongle.kicad_sch, power.kicad_sch, vehicle.kicad_sch]
2026-11-11 Check part stock, swap unavailable parts, add MPN/LCSC fields
    - tools/check_stock.py: LCSC stock via JLCPCB parts API for every BOM line
    - Q101 -> PSMN7R0-60YS, L101 -> Sunlord MWSA0605S-6R8MT,
    C401 -> Kemet T495D227K006ATE100 (better availability)
    - MPN / Manufacturer / LCSC fields on all active parts, docs/bom.csv export
    - docs/bom-notes.md: ESP32-C5-WROOM-1U out of stock (consign),
    OBD plug hand-fitted, EG25-G in stock at Digi-Key
    - Netlist unchanged (112 nets), ERC 0 errors
    [bom.csv, lte.kicad_sch, mcu.kicad_sch, power.kicad_sch, vehicle.kicad_sch]
2026-11-11 Switch LTE modem from EG25-G to EC200U-EU (Cat 1, ~$13 instead of ~$66)
    - New EC200U-EU symbol from Quectel EC200U Hardware Design V1.0
    (pin 76 = GND, pin 35 = BT/Wi-Fi-scan antenna, unused)
    - EC200U has no LTE diversity antenna: removed that U.FL chain,
    GNSS chain renumbered to R410/C413/C414/J403
    - Sourcing: EC200UEUAA-N05-SGNSA (LCSC C2942341, 65 pcs)
    - Reference netlist refreshed after reviewing the diff; ERC 0 errors
    - Docs, BOM and stock-check list updated
    [bom.csv, lte.kicad_sch, obd-v2x-dongle.kicad_sch]
2026-11-11 U301: switch to in-stock ESP32-C5-WROOM-1U-N16R8-V1.2 (LCSC C54951857)
    [bom.csv, mcu.kicad_sch]
2026-11-11 Add ESP32-C5-WROOM-1U (Espressif) and Quectel EC200U footprints, footprint check
    - EC200U LCC+LGA-144 generated from Quectel's recommended footprint (gen_footprints.py)
    - ESP32-C5-WROOM-1U vendored from espressif/kicad-libraries with 3D model
    - check_footprints.py: every symbol pin must have a pad
    - ESP symbol: pin 19 NC/IO15 (PSRAM CS), pin 31 ANT2
    [mcu.kicad_sch]
2026-11-11 Add OBD-II 90deg PCB plug footprint (Jiatel CR-PG001 pattern); ERC 0 warnings
    Pinout of the plug rows is inferred from the drawing: verify on a sample before ordering boards.
    [bom.csv, vehicle.kicad_sch]
2026-11-11 PCB: 52x74 mm 4-layer board, first-pass double-sided placement (gen_pcb.py)
    - outline, stack-up, PCBWay-safe rules, Power/RF net classes, GND planes
    - footprints linked to schematic (parity 0), DNP/BOM attributes and fields copied
    - not routed yet
    [obd-v2x-dongle.kicad_pcb]
2026-11-11 CLAUDE.md: fix KiCad Python path
2026-11-11 PCB: straight antenna chains, pre-route RF lines + via fence and buck SW node (preroute.py)
    [obd-v2x-dongle.kicad_pcb]
2026-11-11 PCB: silkscreen reference placer (silk.py), silk warnings 140 -> 3
    [obd-v2x-dongle.kicad_pcb]
2026-11-11 docs: antenna placement notes for the case; fix antenna cap refs (C411-C414)
2026-11-11 PCB: autorouted (Freerouting 2.5), In1 kept as solid GND plane; WIP: 16 nets left
    [obd-v2x-dongle.kicad_pcb]
2026-11-11 Remove machine-specific paths from the repo
    - kicad_env.py finds KiCad via KICAD_DIR / PATH / default install locations
    - scripts no longer hard-code the local KiCad install folder
    - reference.net stored without the absolute source path and date (check_netlist.py --update)
    - CLAUDE.md: rule to keep local paths and personal info out of the repo
2026-11-11 PCB: switch node as fixed 1 mm tracks (C105 moved, R104 to bottom), reroute; 4 connections left
    Edge clearance rule 0.3 mm (PCBWay milled-edge minimum), zone island removal on.
    [obd-v2x-dongle.kicad_pcb]
2026-11-11 PCB: fully routed, DRC 0 errors / 0 unconnected, schematic parity 0
    - In1 solid GND plane (autorouter kept off it), switch node as locked 1 mm tracks
    - remaining connections + GND stitching vias with tools/maze.py (grid A* router)
    - VBUS_USB moved to the default net class (USB-C fine-pitch fanout)
    - R304 moved to the top side to free the USB-C CC2 fanout
    - renders updated
    [obd-v2x-dongle.kicad_pcb]
2026-11-11 preroute.py: switch node as locked 1 mm tracks (matches the routed board)
2026-11-11 Design review fixes: wide VBAT_F input path, LED part matches footprint, fiducials, VSENSE divider /11
    - Power net class pattern *VBAT_F (net is /Power/VBAT_F); re-routed 1 mm
    - D301 SK6812MINI-HS (top-emitting) instead of reverse-mount SK6812MINI-E
    - 3 fiducials per side for double-sided assembly
    - R110 10k: battery sense full scale ~35 V (jump-start / load dump safe)
    - docs/design-review.md: checks, accessibility, open decisions
    [bom.csv, mcu.kicad_sch, obd-v2x-dongle.kicad_pcb, power.kicad_sch]
2026-11-11 Schematic: eSIM (MFF2) on SIM 1 as default, nano-SIM holder as DNP alternative
    - U403 eSIM (1NCE MFF2 chip, consigned), R411-R413 22R fitted, C415
    - J401 holder kept, its series resistors R405-R407 now DNP (swap to use a plug-in SIM)
    - symbol eSIM_MFF2 (pinout per vendor datasheets), footprint WSON-8 6x5 EP3.4x4
    - PCB not yet updated
    [lte.kicad_sch]
2026-11-11 Schematic: backup battery sheet (BQ25171-Q1 charger + TPS2121 power mux)
    - 1S Li-ion/LiPo on JST-PH (J501), charged from VIN_PROT via 33R + SMF24A clamp,
    91 mA, 4.10 V float, 10 h timer, 10k NTC (0..45 C)
    - TPS2121: IN1 = buck (new rail VBUCK_3V8), IN2 = cell, OUT = VSYS_3V8 (all loads);
    PR1 from VIN_PROT/9.2 switches to the cell below ~9.7 V (also during cranking)
    - 220 uF + 10 uF hold-up on VSYS_3V8
    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
    [battery.kicad_sch, obd-v2x-dongle.kicad_sch, power.kicad_sch]
2026-11-11 PCB: eSIM + backup battery placed and routed (sync_pcb.py, route_unconnected.py)
    - U403 eSIM + R411-R413 next to the SIM holder; R405-R407 now DNP
    - charger U501 (no thermal vias: 70 mA) under the modem area, J501 + NTC on the bottom
    - power mux U502 + 220 uF hold-up moved to the top, below the buck output
    - full re-route: Freerouting with locked pre-routes, RF fence vias slide off pads (3 dropped)
    - DRC 0 errors, parity 0; 3 connections + 1 GND island left for interactive routing
    [battery.kicad_sch, obd-v2x-dongle.kicad_pcb]
2026-11-11 PCB: route VCELL into the power mux (VSYS now leaves U502 on the right side)
    [obd-v2x-dongle.kicad_pcb]
2026-11-11 PCB: route LTE_TXD_1V8 (U402 pad 3 escape cleared); maze via margin
    [obd-v2x-dongle.kicad_pcb]
2026-11-11 PCB: route the last connections by hand; board complete (DRC 0 errors, 0 unconnected, parity 0)
    - KL_TX: VSENSE edge run moved so ESP pads 7/8 reach vias at the board edge
    - LTE_TXD_1V8: GND stitching vias/track cleared from U402 pad 3 escape
    - C405/C407 GND island: via in the 1.1 mm gap between the modem's edge and inner pads
    - C506/C507 solid GND connection; maze.py: power-net margin for stitching vias, edge margin
    [obd-v2x-dongle.kicad_pcb]
2026-11-11 SIM: plug-in nano-SIM holder is the default (Telekom/Vodafone/congstar), soldered eSIM optional (DNP)
    - R405-R407 fitted; U403, C415, R411-R413 DNP (footprints stay)
    - BOM re-exported from the schematic; notes and review updated
    - sync_pcb.py: no net rip-up by default
    [bom.csv, lte.kicad_sch, obd-v2x-dongle.kicad_pcb]
2026-11-12 SIM switch: FSA2567 selects nano-SIM (default) or soldered eSIM
    U404 routes the modem's single SIM interface to J401 (SIM_SEL low, R414
    pull-down) or to the MFF2 eSIM U403 (SIM_SEL high). SIM_SEL is ESP IO12
    (was UART0 RX, still on TP302). eSIM series resistors and cap are now
    fitted; the eSIM chip itself stays DNP until one is chosen.
    [lte.kicad_sch, mcu.kicad_sch]
2026-11-12 PCB: place and route the SIM switch U404
    U404 (FSA2567, UQFN-16 0.4 mm) sits on the bottom side between the ESP and
    the modem, where vias can go anywhere around it (no modem pads above), with
    C416 / R414 next to it. SIM nets routed with Freerouting plus maze.py and a
    few hand-placed escapes; two GND stitching vias next to R412 removed to
    reach its pad. DRC 0 errors / 0 unconnected, parity 0, ERC 0/0, netlist
    matches the reference. Docs, BOM, schematic PDF and renders updated.
    [bom.csv, obd-v2x-dongle.kicad_pcb]
2026-11-12 Pre-order review: PCBWay rules, no via-in-pad, 50 ohm RF, LED pinout, buck compensation
    - Vias in SMD pads moved next to the pads (only the ESP32 EPAD thermal vias stay);
    maze.py never places vias in pads and keeps 1 mm around fiducials
    - RF net class 0.32 mm GCPW (gap 0.25 mm): ~50 ohm on PCBWay's standard 1.6 mm 4-layer stack-up
    - Silkscreen text stroke 0.15 mm (PCBWay minimum)
    - D301: SK6812MINI-HS pinout differs from KiCad's SK6812MINI; own symbol and footprint from
    the OPSCO datasheet, LED re-routed
    - TPS54360 compensation per datasheet method: R106 12k, C105 5.6 nF
    - NX3DV2567GU checked as a drop-in second source for U404
    - sync_pcb.py swaps footprints changed in the schematic; fab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
    [bom.csv, mcu.kicad_sch, obd-v2x-dongle.kicad_pcb, power.kicad_sch]
2026-11-12 GNSS active-antenna bias on J403 (works with passive antennas too)
    - U405 TPS2552-1 latch-off current-limited switch (R_ILIM 232k: 100-137 mA) feeds 3.3 V
    through L401 27 nH (C418 33 pF bypass) onto the U.FL side of the GNSS line
    - R410 0R -> C417 33 pF C0G DC block towards the modem's ANT_GNSS pin
    - Enabled by LTE_PWR_ON_N (Q102 gate, low while the modem is powered); a shorted passive
    antenna latches the switch off until the next modem power cycle
    - LTE sheet now A3; sync_pcb.py keeps locked pre-routes and takes footprint paths from the netlist
    - Stale buck compensation note on the power sheet updated
    - Stray ERC report removed and *-erc.rpt / *-drc.rpt ignored
    [bom.csv, lte.kicad_sch, obd-v2x-dongle.kicad_pcb, power.kicad_sch]
2026-11-12 PCB: straighten the grid router's staircase tracks
    - maze.py smooth: rebuilds chains of unlocked segments from straight 0/45/90 deg pieces or
    45 deg doglegs, each checked against other-net copper (net-class clearance), holes,
    keep-outs and the board edge; vertices with T-junctions/pads stay pinned
    - Board: 3039 -> 2077 track segments; one GND stitching via added for an island
    [obd-v2x-dongle.kicad_pcb]
2026-11-12 fab.py: assembly BOM lists only placed parts (no J201, no test pads); SMD/THT from footprint type
2026-11-12 Firmware: first ESPHome version (LTE, MQTT/HA, V2X -> OpenTrafficMap, OBD-II)
    - obd-v2x-dongle.yaml for ESPHome 2026.11 (modem component): EC200U power-up (PWRKEY, STATUS),
    LTE via PPP/CMUX, SIM switch, MQTT with Home Assistant discovery, car battery voltage,
    engine-running detection, status LED
    - components/otm_uplink: second MQTT client publishing ITS-G5 frames to OpenTrafficMap
    - components/obd2: OBD-II mode 01 over CAN on the TWAI node driver (esp32_can does not link
    on the ESP32-C5); only active while the engine runs, transceiver in standby otherwise
    - secrets.example.yaml, README with architecture and roadmap; compile-tested, not run on hardware
2026-11-12 Firmware: GPS from the EC200U, Home Assistant device tracker, Traccar
    - components/ec200u_gnss: starts the GNSS receiver (AT+QGPS=1) and polls AT+QGPSLOC=2 through
    the modem component's send_at; reads the reply from its log line via a logger listener
    (the stock component only logs AT replies). Sensors: lat/lon/altitude/speed/course/HDOP/satellites
    - MQTT: device_tracker discovery + JSON attributes for the HA map
    - Traccar via http_request (OsmAnd): 10 s while the engine runs, 5 min parked, with ignition
    and car battery voltage; URL and device id from secrets
2026-11-12 Firmware: parking mode / deep sleep, settings in Home Assistant
    - components/power_manager: modes driving / parked / check / report; timer wakes keep time
    since the last report in RTC memory, a quick ADC check goes straight back to sleep unless
    the engine runs, the car was unplugged or a report is due; modem shut down (AT+QPOWD,
    supply off) before deep sleep
    - All thresholds and intervals are HA number entities (restore_value, command_retain so a
    change reaches a sleeping dongle on its next wake); "Stay awake" switch, "Power mode" sensor,
    "Unplugged" binary sensor
    - Modem only powered when a wake needs the network; Traccar success marks the report done
    - MQTT birth/will/shutdown of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
2026-11-12 Firmware 0.4: updates over LTE, VIN and fault codes, backup cell cut-off
    - update/ota http_request: the dongle fetches a manifest + image from an https URL (secret), checks at every
    network connect; Home Assistant update entity, "Install updates automatically" switch for a parked car;
    safe_mode + app rollback. tools/make_release.py writes the manifest.
    - obd2: ISO-TP multi-frame receive per ECU with flow control, VIN (09/02), stored fault codes (03) at engine
    start and every 5 min, clear button (04), negative responses logged. Up to 4 frames in the TX queue.
    - ec200u_gnss: modem supply voltage (AT+CBC) = backup cell voltage when unplugged.
    - power_manager: below "Backup cell cut-off" w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
2026-11-12 Firmware 0.5: WireGuard tunnel home, ESPHome default OTA alongside the self-fetched update
    - wireguard (sntp time): the MQTT broker, Traccar and update files stay in the home network; only the home
    and tunnel ranges are routed through it, keepalive 25 s keeps the carrier NAT open for incoming connections.
    - ota: esphome (encrypted with the API key) for ESPHome Builder "Install -> Wirelessly" at the tunnel
    address (modem use_address), next to http_request for a parked car.
    - api for the Builder's logs only (reboot_timeout 0); entities stay on MQTT because the dongle sleeps.
    - secrets example and README updated.
    [obd-v2x-dongle.yaml]
2026-11-12 firmware: faster modem link, capped OpenTrafficMap queue, PSRAM, V2X data counter
    - Modem UART at 921600 baud (4 KB buffers) instead of 115200 (~11 kB/s, too slow
    for busy roads); the modem component switches the EC200U with AT+IPR
    - OpenTrafficMap uplink drops new frames while the esp-mqtt outbox holds more
    than 64 KB instead of growing it until the heap runs out
    - Enable the module's 8 MB PSRAM
    - New sensors: V2X data sent (MB), V2X upload dropped
    - README: data usage note; version 0.6.0
    [obd-v2x-dongle.yaml]
2026-11-13 PCB: front edge at the OBD plug's housing rear face, board 52 x 65 mm
    - J201 footprint from the Jiatel CR-PG001 drawing: housing rear face 5.65 mm from the outer
    leg row; the whole 20 mm housing now sits in front of the board, so a case can grip the
    retention groove behind the rear flange on all four sides (fits any J1962 socket)
    - Board shortened from 74 to 65 mm; CAN/K-line parts moved down, TP301/TP302 moved out of
    the ESP32 pad corridor, FID2 moved clear of copper
    - Re-routed (Freerouting + maze.py); RF and buck SW pre-routes unchanged and locked
    - DRC 0 errors / 0 unconnected, parity 0, ERC 0; netlist matches reference
    - Docs: board size, plug/case notes, Freerouting tips; renders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
    [obd-v2x-dongle.kicad_pcb]
2026-11-13 firmware tools: read-only OBD/UDS probe for a WiCAN (ELM327 over TCP)
    obd_probe.py tests what the car answers before it goes into the firmware:
    supported mode-01 PIDs per ECU, the OBDb C-Class candidate DIDs (odometer,
    oil temp, fuel litres, gear, ATF temp, boost/DPF), ECU discovery via tester
    present, DID range scans, a live byte-change watch and scan diffs.
    Only read services are sent (01, 21, 22, 1A, 3E, 10 01/03). VINs are masked
    on screen and in scan files; raw logs go to the git-ignored probe-logs/.
2026-11-13 PCB: smooth routed track staircases; maze.py no longer pins them at pads
    smooth() treated every vertex inside a pad as an anchor, so staircase
    corners next to pads survived. Degree-2 vertices inside a pad are no longer
    anchors, and a pad at a chain end only pins that end point.
    Board re-smoothed: DRC 0 errors / 0 unconnected, parity 0 (2 cosmetic J301
    silk-edge warnings).
    [obd-v2x-dongle.kicad_pcb]
2026-11-13 docs: refresh board renders after track smoothing
2026-11-13 mechanical: parametric two-part case (build123d)
    case.py builds bottom shell + lid around the board's KiCad STEP model: ledges and
    press ribs where no part is near the edge, U-rib + bottom rib in the OBD plug's
    retention groove, M2.5 screws beside the plug, rear hooks, USB-C opening, RESET/BOOT
    pin guides, LED light-pipe tube, backup-cell pocket. --check reports overlaps with
    PCB, parts and plug; --render writes previews. Plug values marked MEASURE are from
    the drawing until the real plug is measured.
    [case_bottom.step, case_bottom.stl, case_lid.step, case_lid.stl]
2026-11-14 obd_probe: leave WiCAN's own filter and flow control for OBD IDs 7E0-7E7
    Explicit ATCRA/ATFCSM settings for the engine ECU made a WiCAN miss its
    answers on the car. find-ecus now says plainly that a WiCAN in ELM327 mode
    only passes 7E8-7EF without a receive filter.
2026-11-14 obd_probe: SLCAN mode (--slcan) to reach ECUs outside 7E8-7EF
    A WiCAN in ELM327 mode only passes response IDs 7E8-7EF and has no wildcard
    filter, so Mercedes modules with their own diagnostic IDs (instrument
    cluster, EZS) never show up. With the WiCAN in SLCAN mode the script gets
    raw CAN frames and does ISO-TP itself (single/first/consecutive frames,
    flow control, response pending), keeping only frames that can answer the
    request so other bus traffic doesn't interfere.
2026-11-14 obd_probe: no find-ecus sweep over SLCAN, no request IDs below 400
    A tester-present sweep over raw CAN (SLCAN) made a W205 start a Mercedes
    service call: a module took one of the frames for a button press.
    find-ecus is now refused in SLCAN mode and below ID 400; SLCAN stays
    available for known request/response pairs (dids, watch, raw).
2026-11-14 obd_probe: listen-only sniff mode, timestamps in every log
    sniff opens the WiCAN in SLCAN listen-only mode (no ACK, no transmit) and
    records all bus traffic with timestamps; Enter writes a numbered mark,
    q + Enter stops. The W205's OBD port carries a live vehicle bus, so values
    like odometer (0x309), range (0x147) and fuel level (0x2B9) can be read
    without sending anything. Sent SLCAN frames are now logged with spaces so
    the VIN mask no longer hides them.
2026-11-14 vehicles: add W205 outside temperature (0x309 byte 3), note TPMS needs a drive
    Outside temperature is broadcast in the odometer message 0x309 byte 3
    (raw x 0.5 - 40 C, 0x5E = 7.0 C, stable across two recordings). TPMS
    pressures are not in the stationary logs (sensors sleep when parked), so
    they are listed as a candidate to capture while driving. Number signals
    gain an optional offset field.
2026-11-14 vehicles: W205 voltage, reverse, parking brake and light switch signals
    From a listen-only recording with the engine running: battery voltage
    0x122 byte 0 x 0.1 V (matches engine off / starting / running), reverse
    gear 0x020 byte 4 bit 0x02, parking brake 0x353 byte 7 (33 applied, 44
    released), light switch position 0x335 byte 4 (bit 0x04 = fog button).
    Brake pedal, seatbelt and Start/Stop are candidates seen once; indicators,
    hazards, windows and clutch are not on this bus.
2026-11-14 vehicles: W205 0x020 is the driver seatbelt, not reverse
    With the actual action order, 0x020 byte 4 bit 0x02 follows the driver's
    belt. Parking brake (0x353) moves back to candidates until the order of the
    middle marks is known; passenger belt candidate 0x225 byte 2 added.
2026-11-14 vehicles: W205 belts, brake pedal, reverse and ECO Start/Stop
    With the confirmed action order of the marked recording: passenger belt
    0x225 byte 2, brake pedal 0x351 byte 1 bit 0x20, reverse gear 0x2CF byte 5
    bit 0x01, ECO Start/Stop 0x141 byte 0 bit 0x20. Electric parking brake,
    indicators, hazards, windows and clutch are not on this bus; 0x353 is not
    the parking brake.
2026-11-14 obd2: vehicle profiles, broadcast signals decoded listen-only, switchable in HA
    Every firmware/vehicles/*.json is compiled in (components/obd2/profiles.py
    validates it at build time). A 'Vehicle profile' select (stored in flash)
    picks the active one; entities are declared per signal name under signals:
    of the obd2 sensor / binary_sensor / text_sensor platforms (number, flag,
    enum; enums may name an 'on' state and a bit mask).
    The TWAI node now accepts all standard frames and the ISR queues only the
    OBD responses plus the active profile's IDs. Signals are decoded without
    sending anything; flags and states publish on change, numbers at most every
    signal_interval. After the engine stops the no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
2026-11-14 W205 profile: tyre pressures, parking brake and A/C from a drive recording
    0x409 bytes 0-3 are the TPMS pressures (x2.5 kPa, 0xFF until the sensors
    report while driving; all four matched the cluster). 0x225 byte 2 is the
    parking brake (mask 0x0F: 3 applied, 4 released, 1/2/9 motor running), not
    the passenger belt. 0x353 byte 1 bit 0x04 follows the A/C. Reverse
    (0x2CF) moves back to candidates: it stayed set while driving forward.
    YAML gains the four tyre pressures, parking brake and A/C entities.
    [obd-v2x-dongle.yaml]
2026-11-14 W205 profile: tyre pressure left/right mirrored
    The cluster draws the car from its left side; the values under the near
    (left) wheels are 225 front and 255 rear. 0x409 bytes 0-3 are rear right,
    rear left, front left, front right, consistent with both cluster photos.
2026-11-14 obd2: keep last known signal values, optional restore from flash
    'Not available' readings (profile invalid values, e.g. tyre sensors that
    have not reported yet, range/fuel right after the engine stops) are now
    skipped instead of published as unknown, so entities keep their last value.
    restore: true on a signal entity keeps the last valid raw value in flash
    (per entity preference, tagged with the profile it was decoded with),
    written at engine stop and when listening ends, and shows it again after a
    reboot or deep sleep. Enabled for odometer, range, fuel level, tyre
    pressures and locked. Entity names without '/' (reserved by ESPHome).
    [obd-v2x-dongle.yaml, obd2.cpp, obd2.h, profiles.py]
